Ricsi1231/BLDC-Motor-Driver/BLDC Motor Driver/Documentation/Schematic/Schematic.pdf

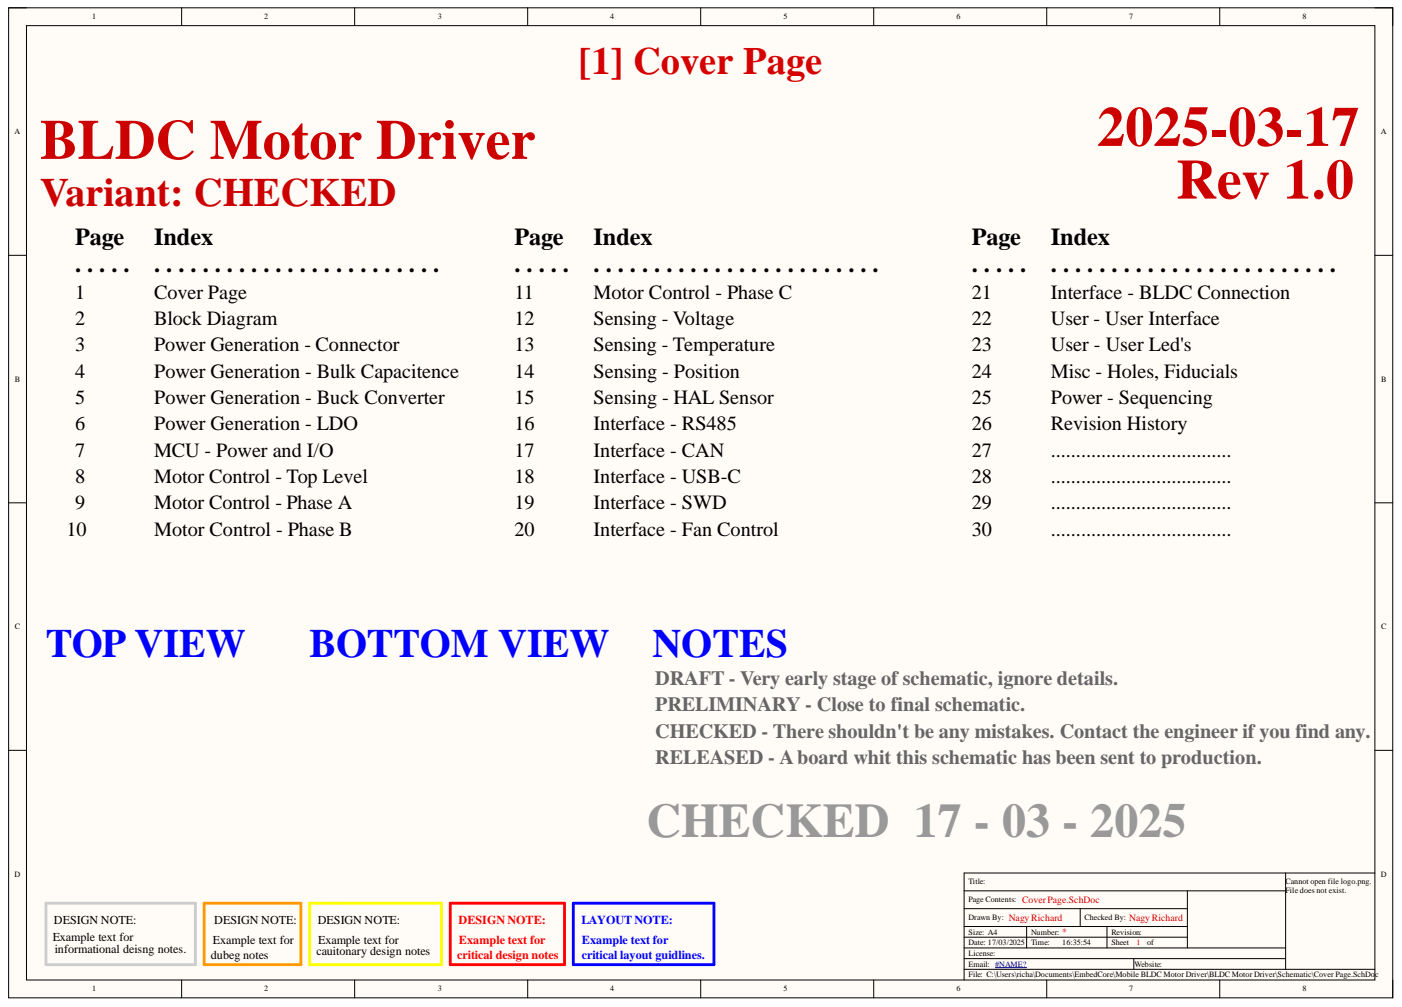
[picture p1: page 1]

Index
Cover Page
Block Diagram
Power Generation - Connector
Power Generation - Bulk Capacitence
Power Generation - Buck Converter
Power Generation - LDO
MCU - Power and I/O
Motor Control - Top Level
Motor Control - Phase A
Motor Control - Phase B

DRAFT - Very early stage of schematic, ignore details.
PRELIMINARY - Close to final schematic.
CHECKED - There shouldn't be any mistakes. Contact the engineer if you find any.
RELEASED - A board whit this schematic has been sent to production.
CHECKED 17 - 03 - 2025

Cannot open file logo.png.
File does not exist.

Page Contents: Cover Page.SchDoc

DESIGN NOTE:
Example text for cauitonary design notes

Drawn By: Nagy Richard | Checked By: Nagy Richard
Size: A4 | Number: * | Revision:
Date: 17/03/2025 | Time: 16:35:54 | Sheet of

License:
Email: #NAME?
C:\Users\richa\Documents\EmbedCore\Mobile BLDC Motor Driver\BLDC Motor Driver\Schematic\Cover Page.SchDoc

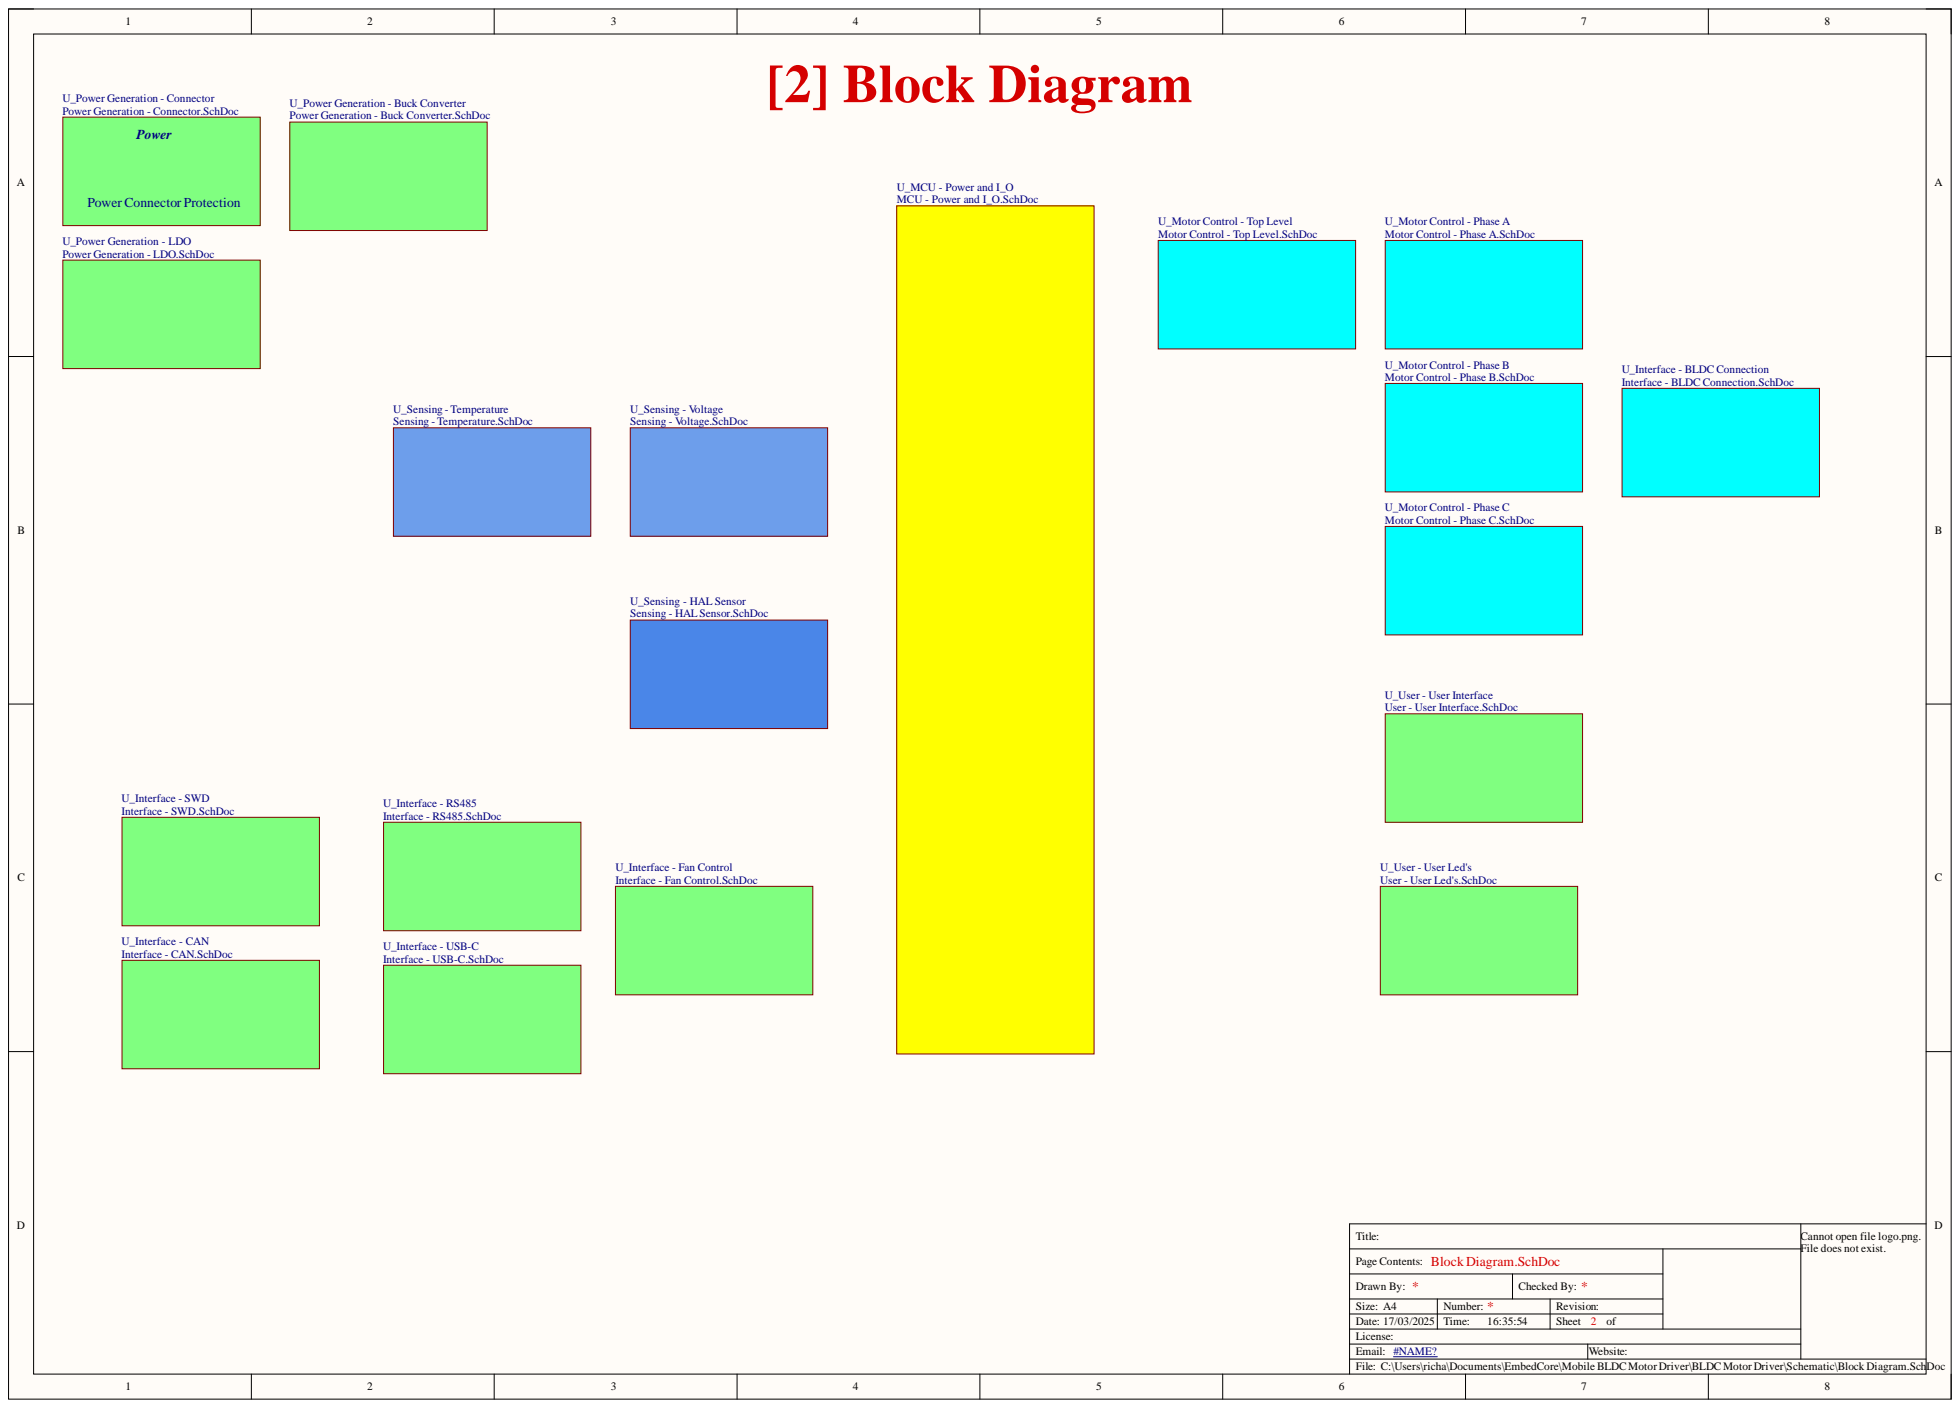
[picture p2: page 2]

U_MCU - Power and I_O
MCU - Power and I_O.SchDoc

U_Motor Control - Top Level
Motor Control - Top Level.SchDoc

U_Motor Control - Phase A
Motor Control - Phase A.SchDoc

U_Power Generation - LDO
Power Generation - LDO.SchDoc

U_Motor Control - Phase B
Motor Control - Phase B.SchDoc

U_Interface - BLDC Connection
Interface - BLDC Connection.SchDoc

U_Motor Control - Phase C
Motor Control - Phase C.SchDoc

U_User - User Interface
User - User Interface.SchDoc

U_Interface - Fan Control
Interface - Fan Control.SchDoc

U_User - User Led's
User - User Led's.SchDoc

Cannot open file logo.png.
File does not exist.

Page Contents: Block Diagram.SchDoc

Drawn By: * | Checked By: *
Size: A4 | Number: * | Revision:
Date: 17/03/2025 | Time: 16:35:54 | Sheet of

License:
Email: #NAME?
C:\Users\richa\Documents\EmbedCore\Mobile BLDCMotor Driver\BLDCMotor Driver\Schematic\Block Diagram.SchDoc

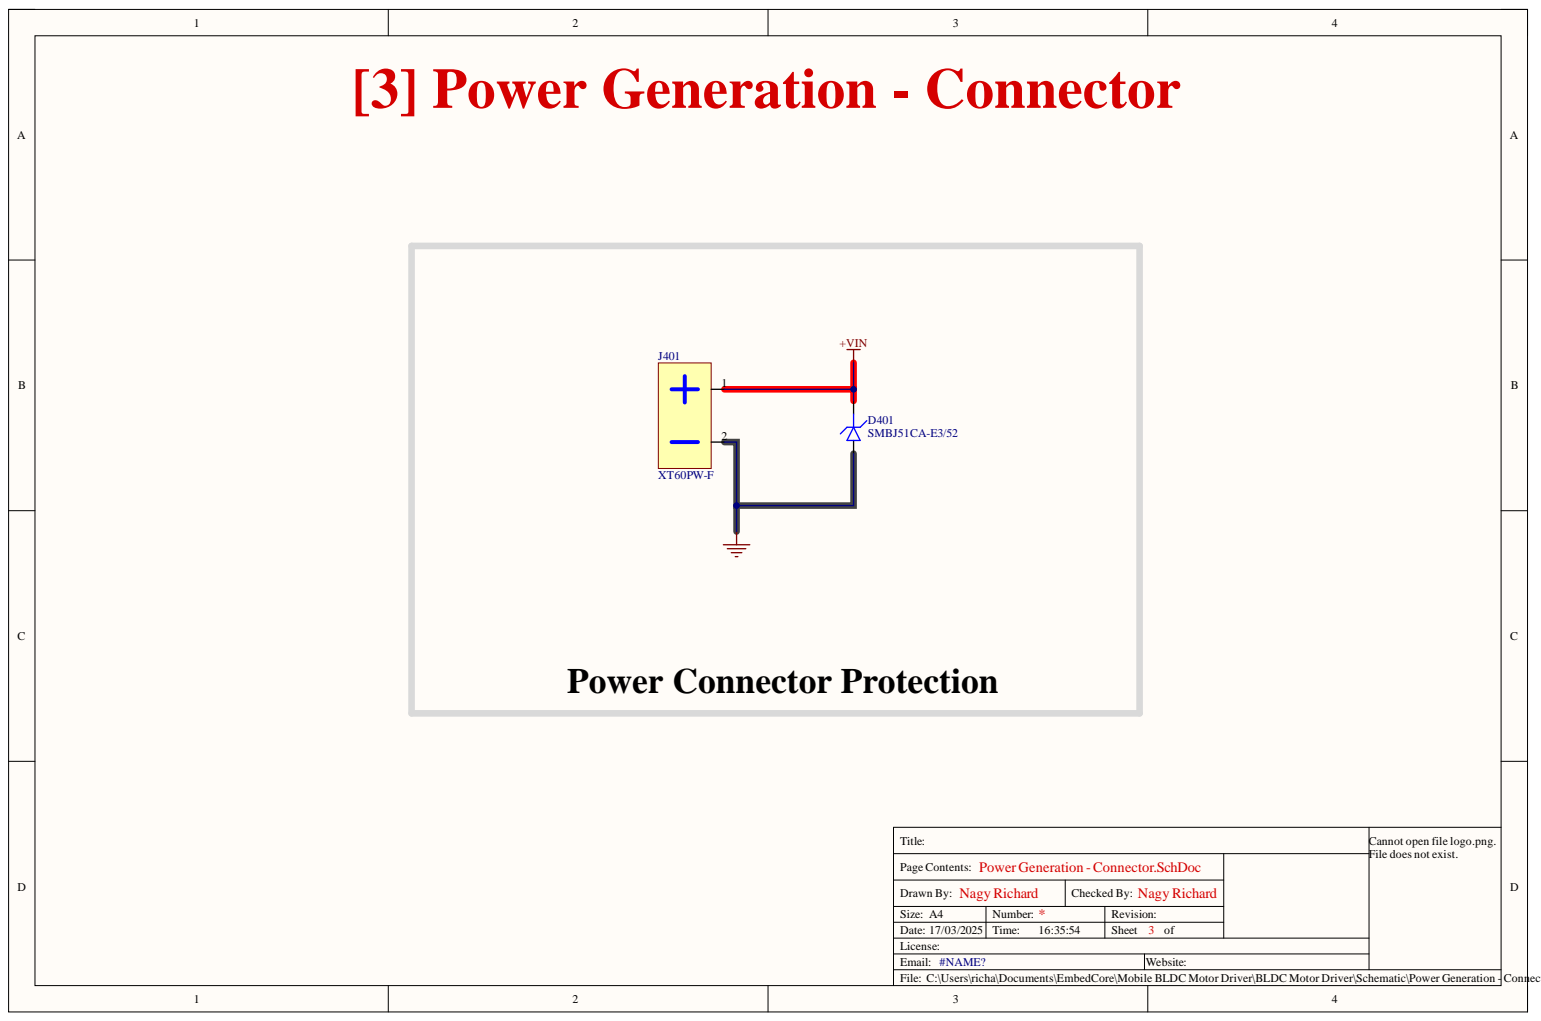
[picture p3: page 3]

Page Co n ten t s : P ower Ge n eratio n - Co n n e cto r.S c h D o c

Draw n By : Na g yRic h ard | Checked By : Na g yRic h ard
Size : A 4 | * N umb er : | Rev i s i o n :
Dat e : 1 7 / 0 3 / 2 0 2 5 | T ime : 1 6 : 3 5 : 5 4 | Shee t 3 o f

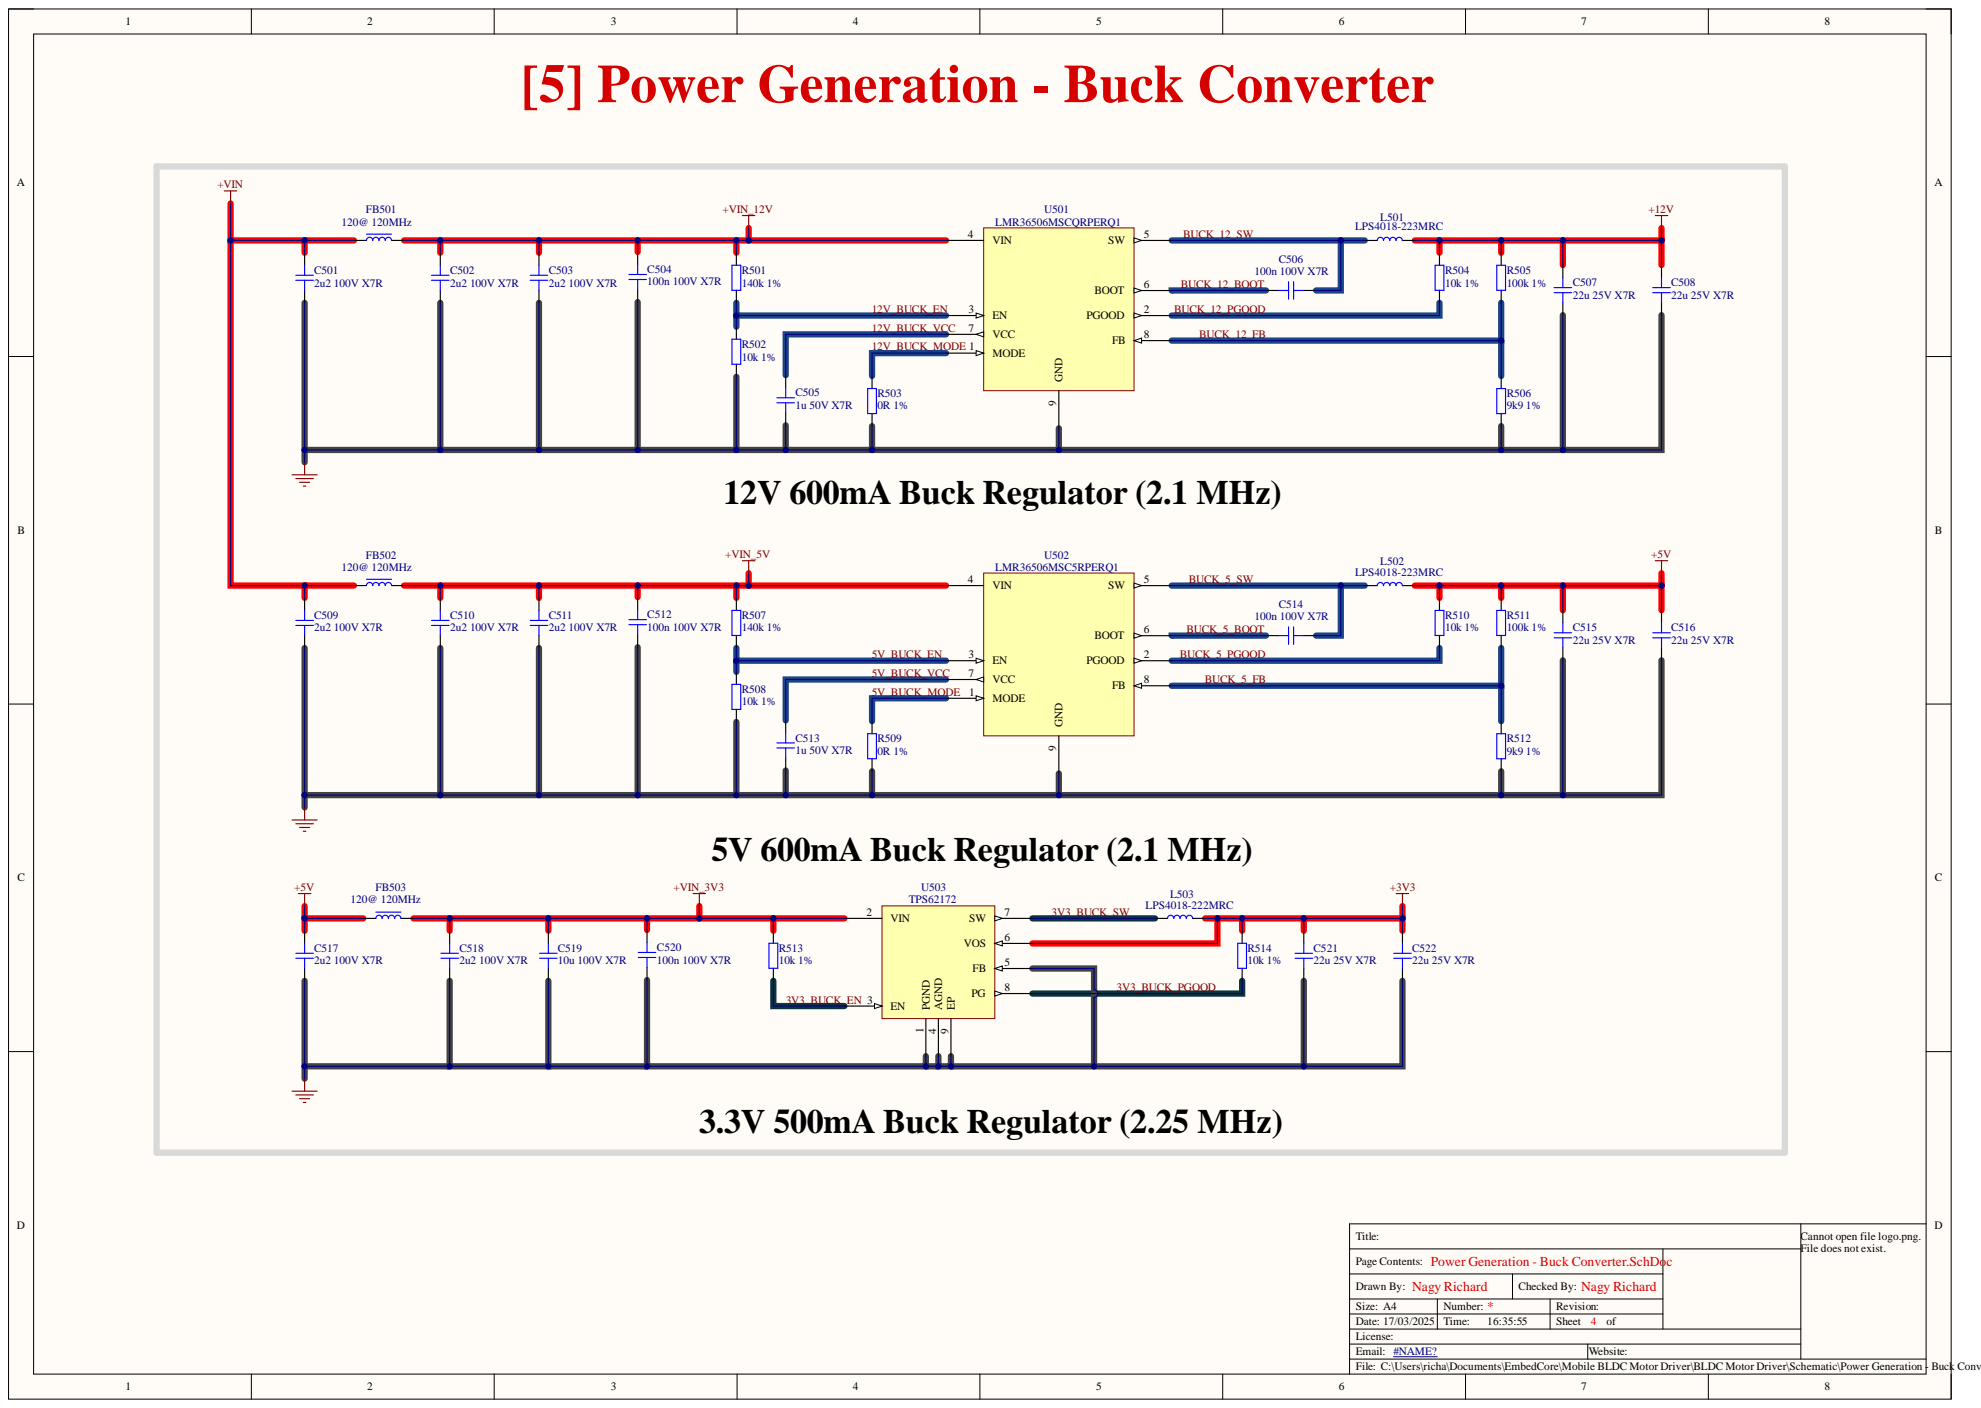
[picture p4: page 4]

[5] Power Generation - Buck Converter

12V_BUCK_VCC | VCC 7 | BUCK_12_FB
12V_BUCK_MODE

5V_BUCK_VCC | VCC 7 | BUCK_5_FB
5V_BUCK_MODE

Cannot open file logo.png.
File does not exist.

Page Contents: Power Generation - Buck Converter.SchDoc

Drawn By: Nagy Richard | Checked By: Nagy Richard
Size: A4 | Number: * | Revision:
Date: 17/03/2025 | Time: 16:35:55 | Sheet of

License:
Email: #NAME?
C:\Users\richa\Documents\EmbedCore\Mobile BLDC Motor Driver\BLDC Motor Driver\Schematic\Power Generation - Buck Converter.SchDoc

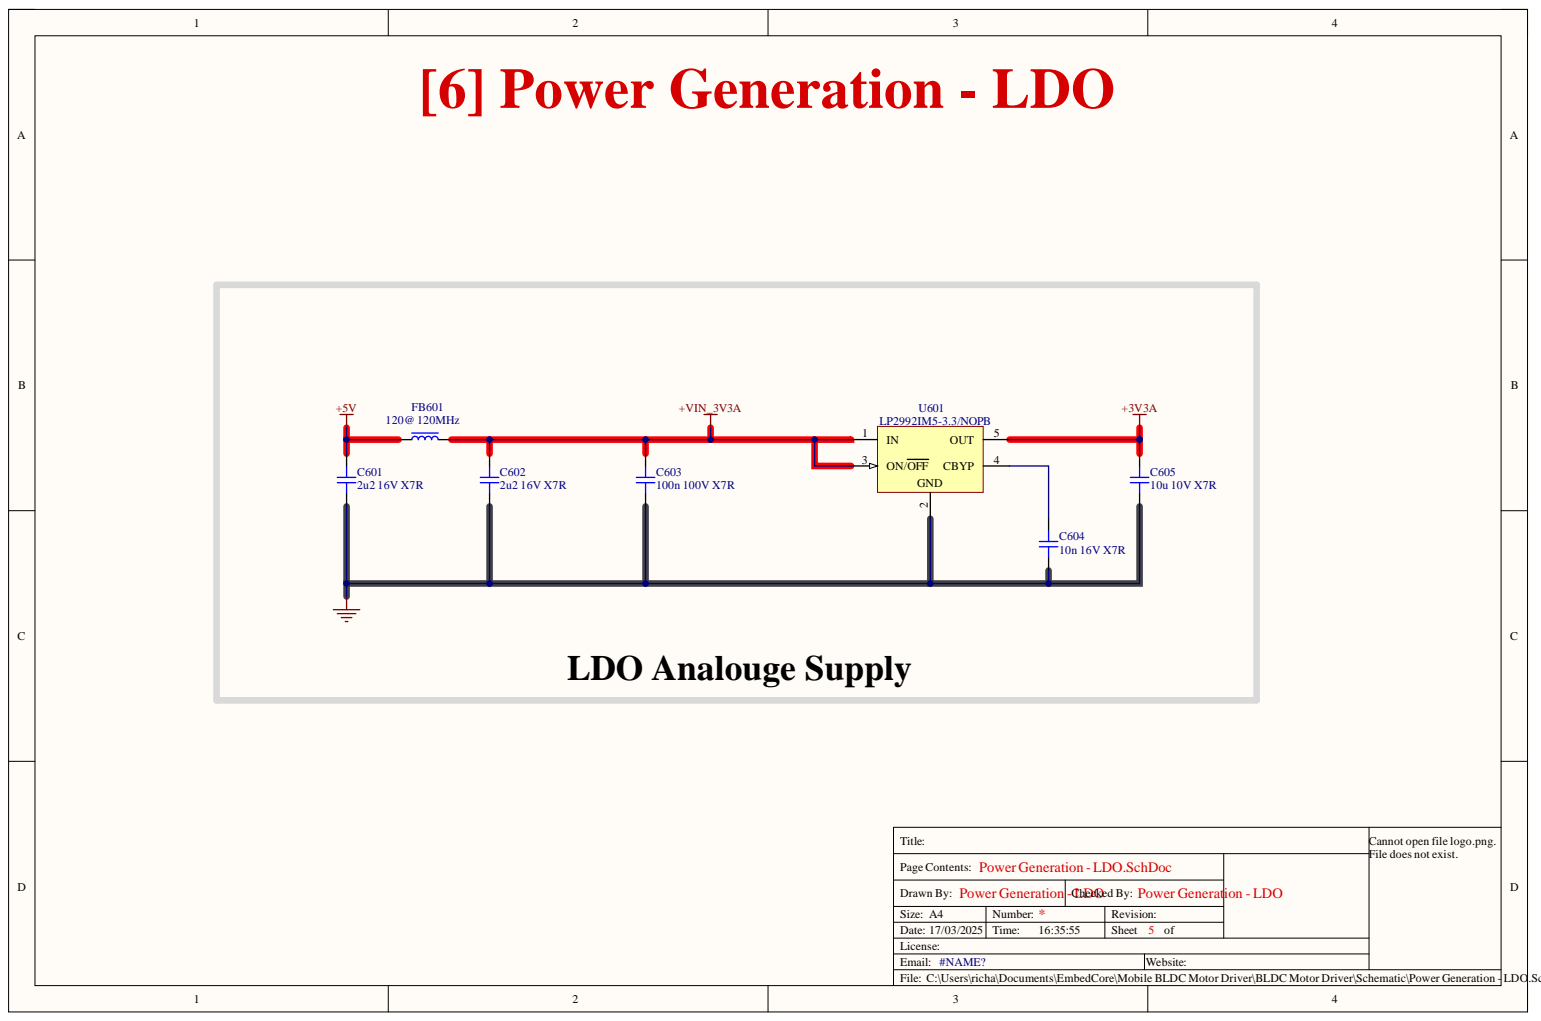
[picture p5: page 5]

Page Co n ten t s : P ower Ge n eratio n - LDO.S c h D o c | n - LDO

Draw n By : P ower Ge n eratio n - ChLDOecked By | : P ower Ge n eratio
Size : A 4 | * N umb er : | Rev i s i o n :
Dat e : 1 7 / 0 3 / 2 0 2 5 | T ime : 1 6 : 3 5 : 5 5 | Shee t 5 o f

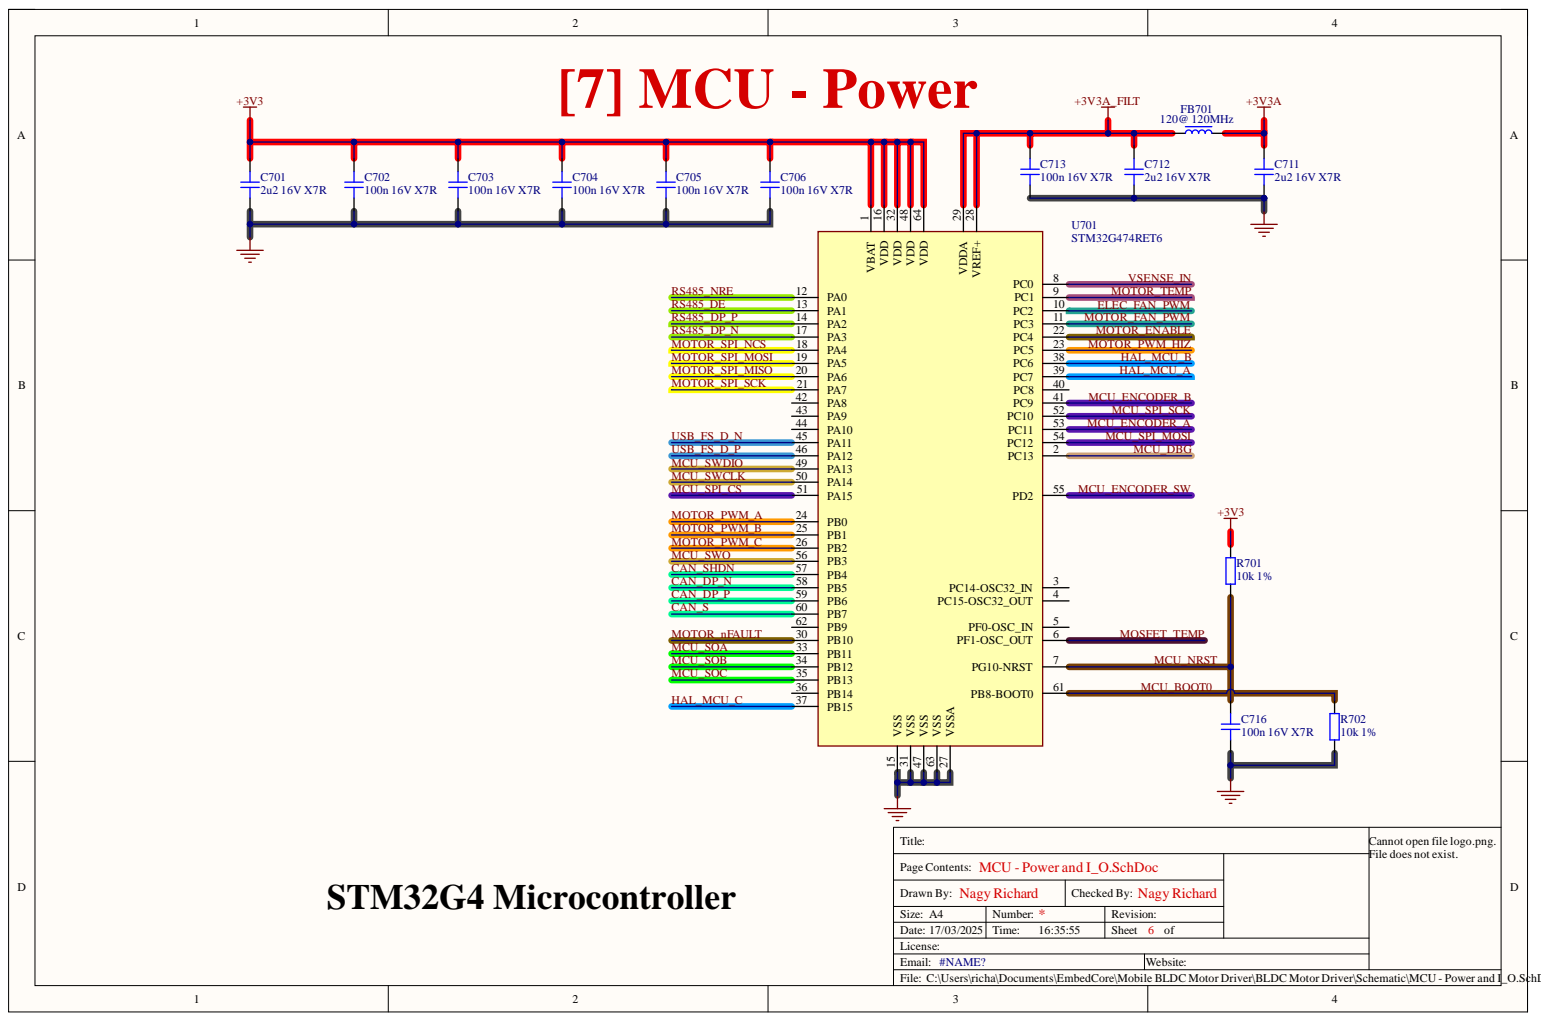
[picture p6: page 6]

Page Co n ten t s : MCU -P ower a n d I_O.S c hDo

Draw n By : Na g yRic h ard | Checked By : Na g yRic h ard
Size : A 4 | * N umb er : | Rev i s i o n :
Dat e : 1 7 / 0 3 / 2 0 2 5 | T ime : 1 6 : 3 5 : 5 5 | Shee t 6 o f

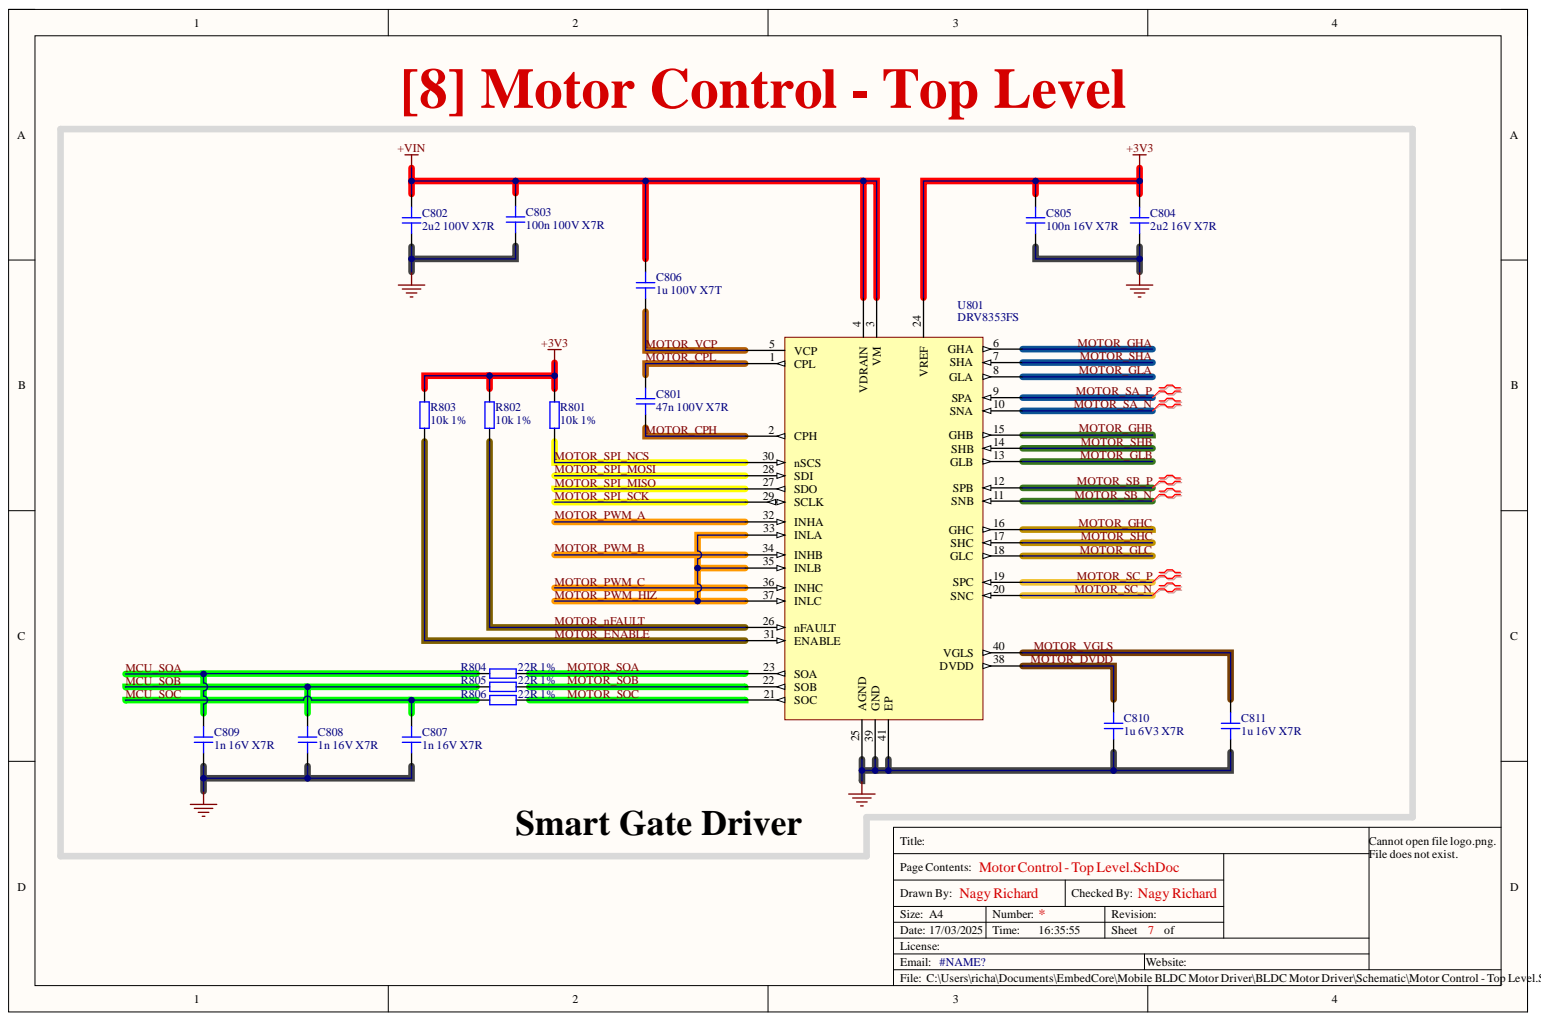
[picture p7: page 7]

[8] Motor Control - Top Level

Page Co n ten t s : M otor Co ntrol -To p Le v el.S c hDo c

Draw n By : Na g yRic h ard | Checked By : Na g yRic h ard
Size : A 4 | * N umb er : | Rev i s i o n :
Dat e : 1 7 / 0 3 / 2 0 2 5 | T ime : 1 6 : 3 5 : 5 5 | Shee t 7 o f

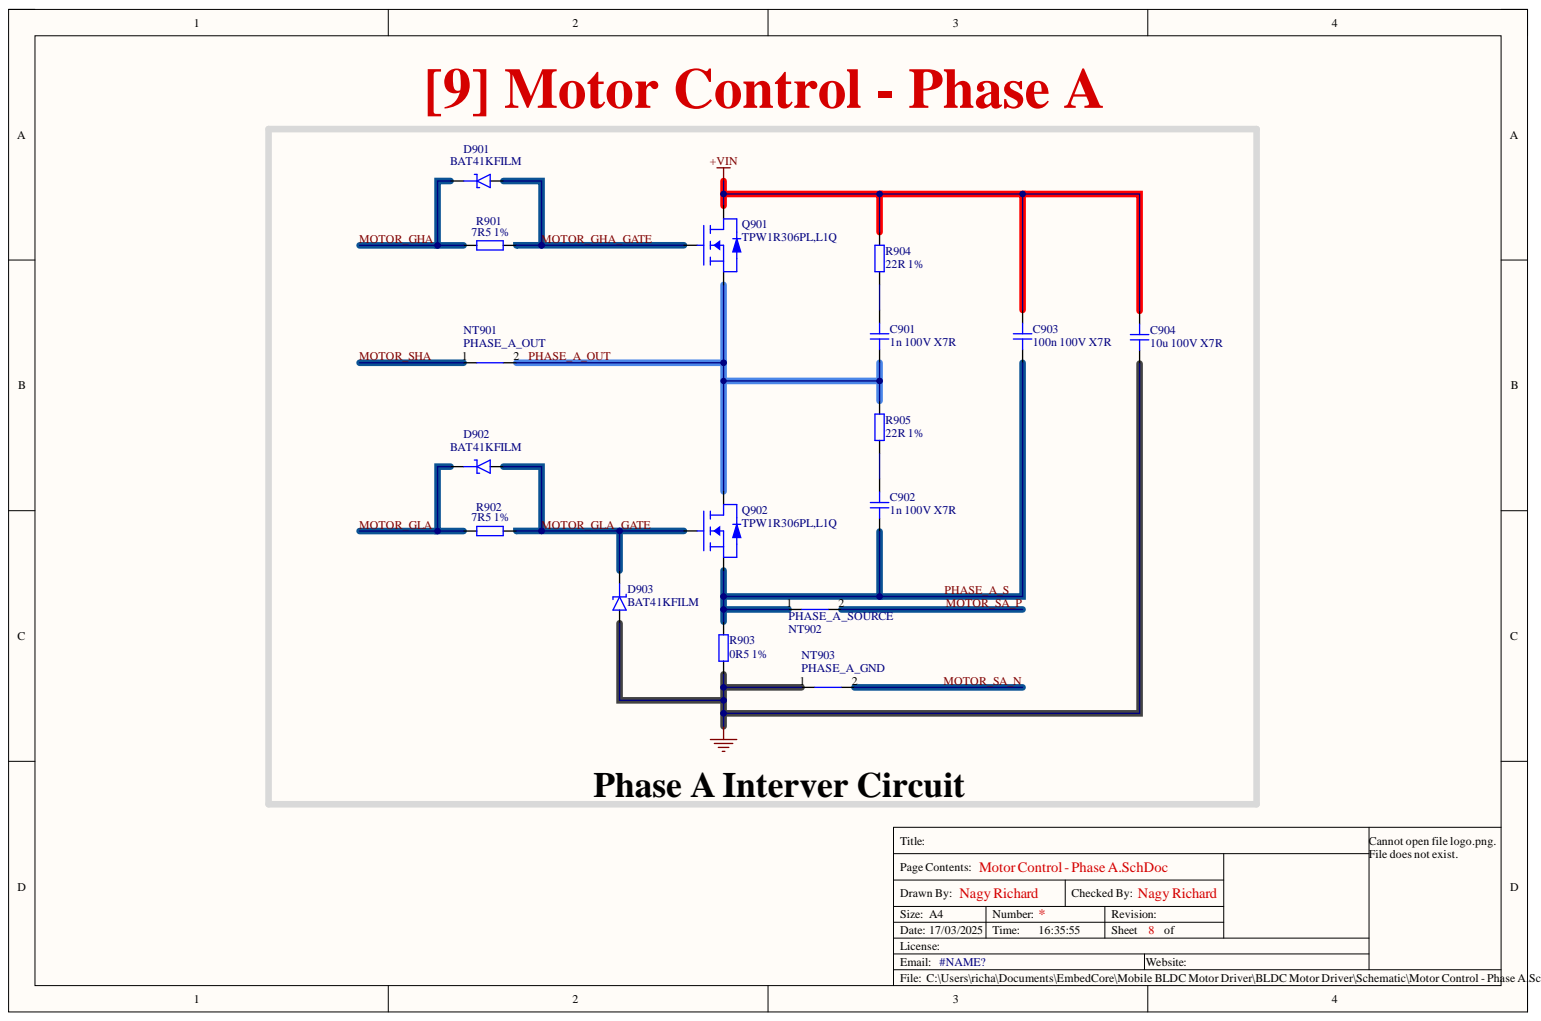
[picture p8: page 8]

Cannot open file logo.png.
File does not exist.

Page Contents: Motor Control - Phase A.SchDoc

Drawn By: NagyRichard | Checked By: NagyRichard
Size: A4 | * Number: | Revision:
Date: 17/03/2025 | Time: 16:35:55 | Sheet 8 of

License:
Email: #NAME?
C:\Users\richa\Documents\EmbedCore\Mobile BLDC Motor Driver\BLDC Motor Driver\Schematic\Motor Control - Phase A.SchDoc

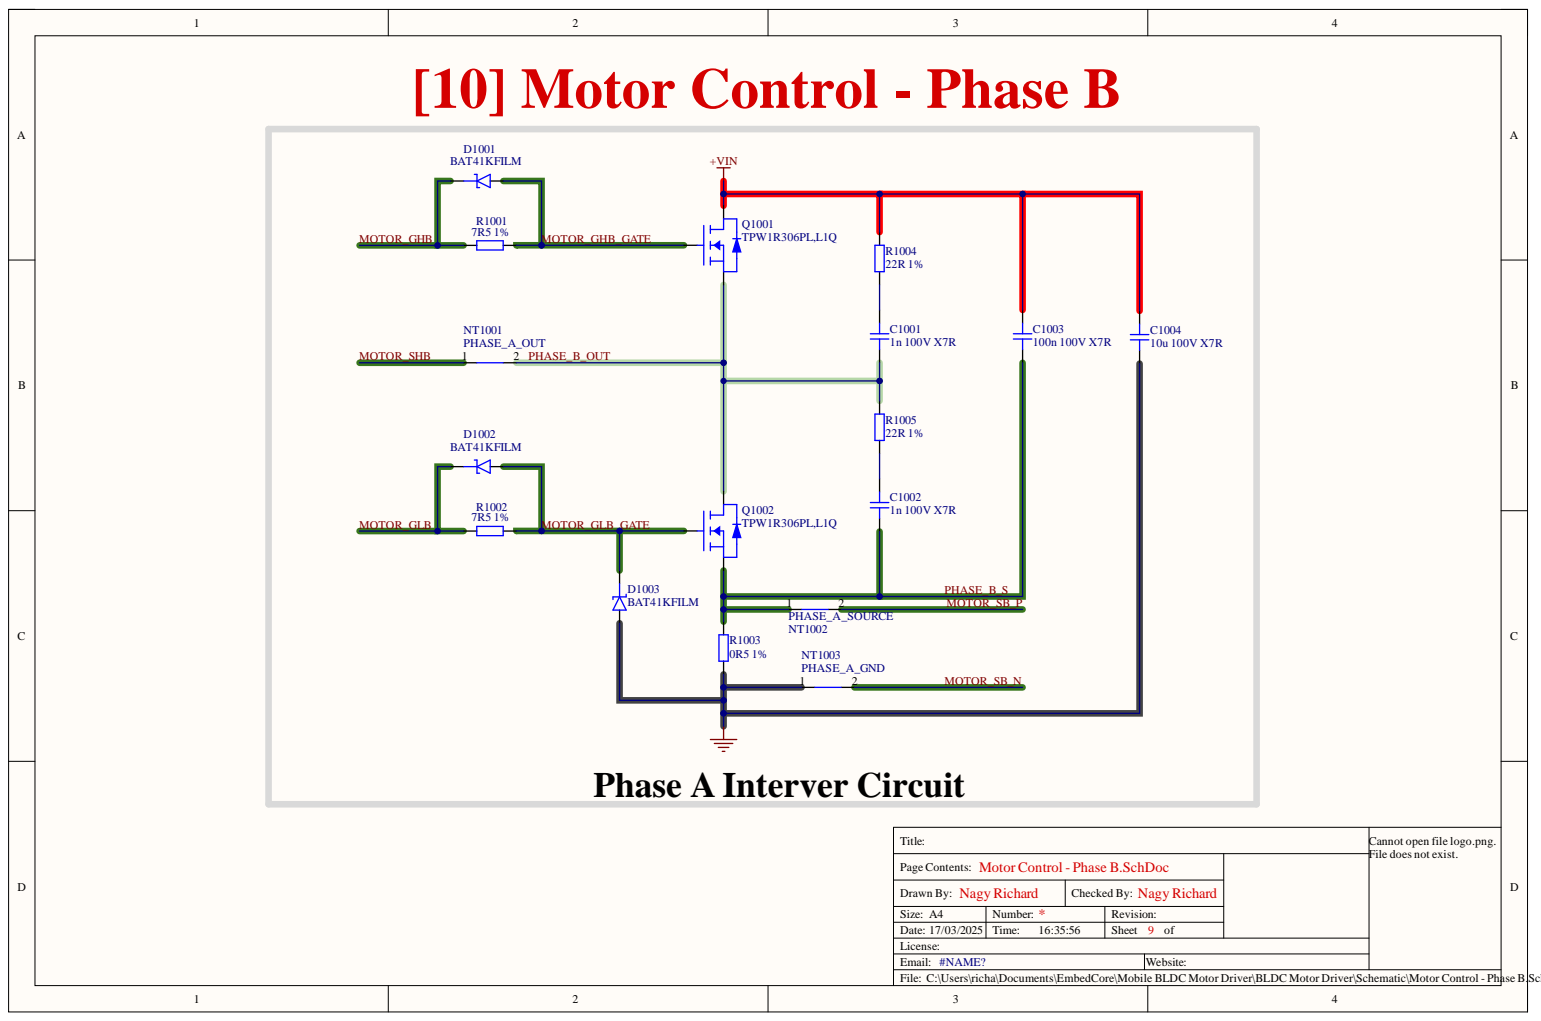
[picture p9: page 9]

Cannot open file logo.png.
File does not exist.

Page Contents: Motor Control - Phase B.SchDoc

Drawn By: NagyRichard | Checked By: NagyRichard
Size: A4 | * Number: | Revision:
Date: 17/03/2025 | Time: 16:35:56 | Sheet 9 of

License:
Email: #NAME?
C:\Users\richa\Documents\EmbedCore\Mobile BLDC Motor Driver\BLDC Motor Driver\Schematic\Motor Control - Phase B.SchDoc

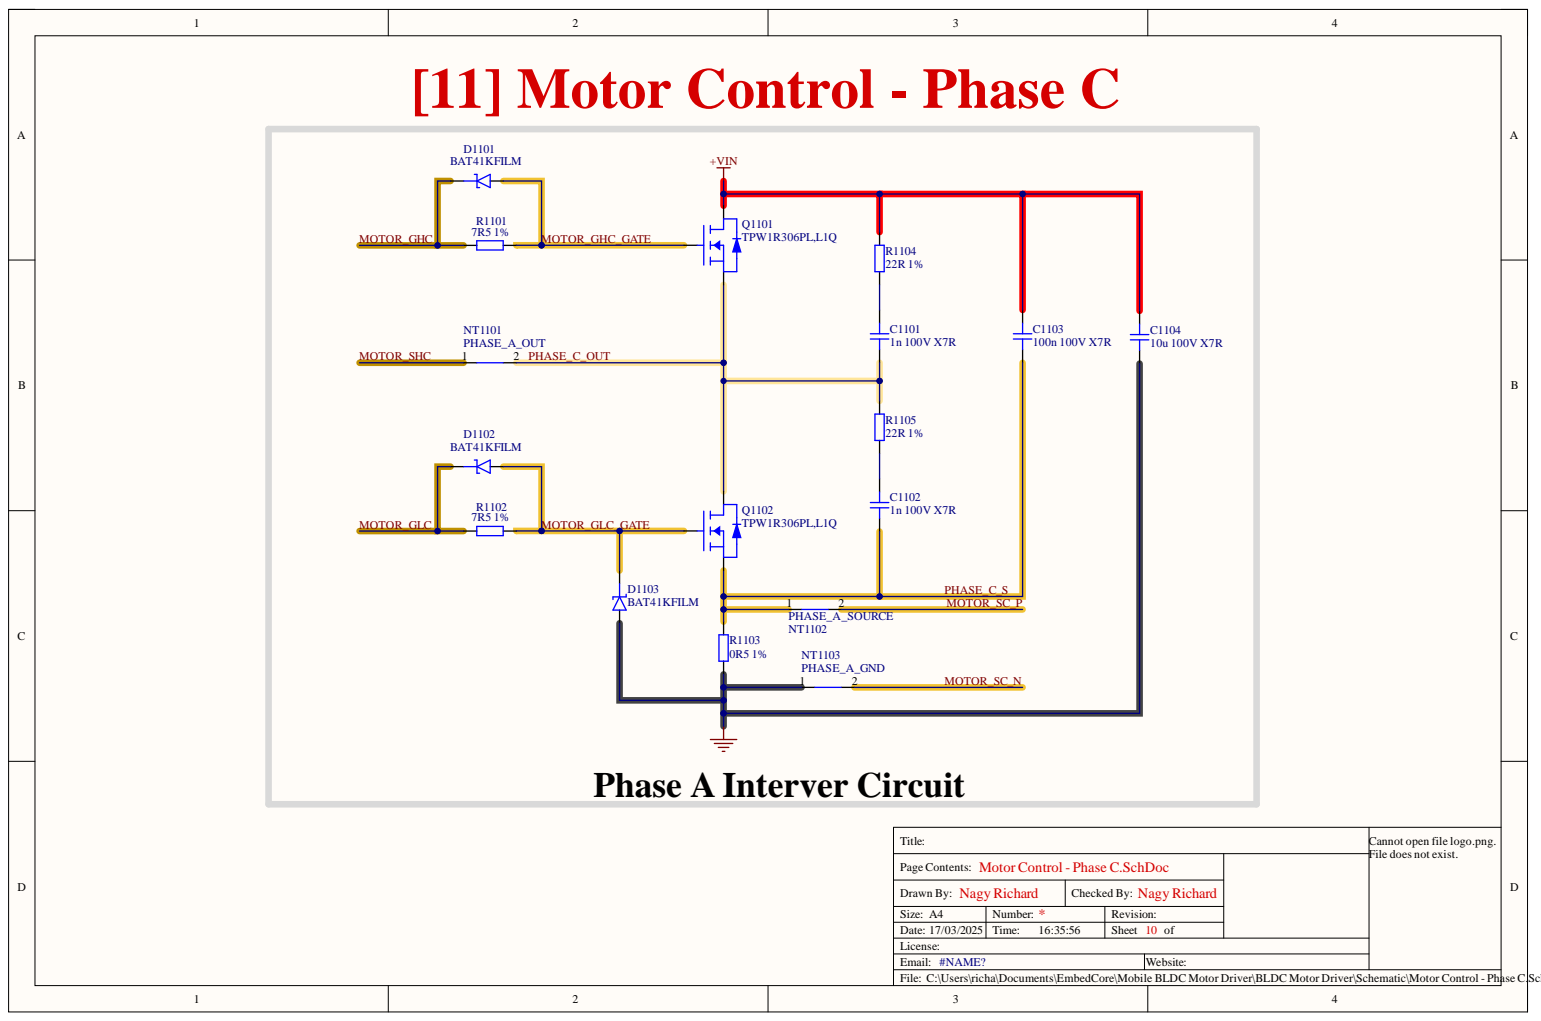
[picture p10: page 10]

Cannot open file logo.png.
File does not exist.

Page Contents: Motor Control - Phase C.SchDoc

Drawn By: NagyRichard | Checked By: NagyRichard
Size: A4 | * Number: | Revision:
Date: 17/03/2025 | Time: 16:35:56 | Sheet 10 of

License:
Email: #NAME?
C:\Users\richa\Documents\EmbedCore\Mobile BLDC Motor Driver\BLDC Motor Driver\Schematic\Motor Control - Phase C.SchDoc

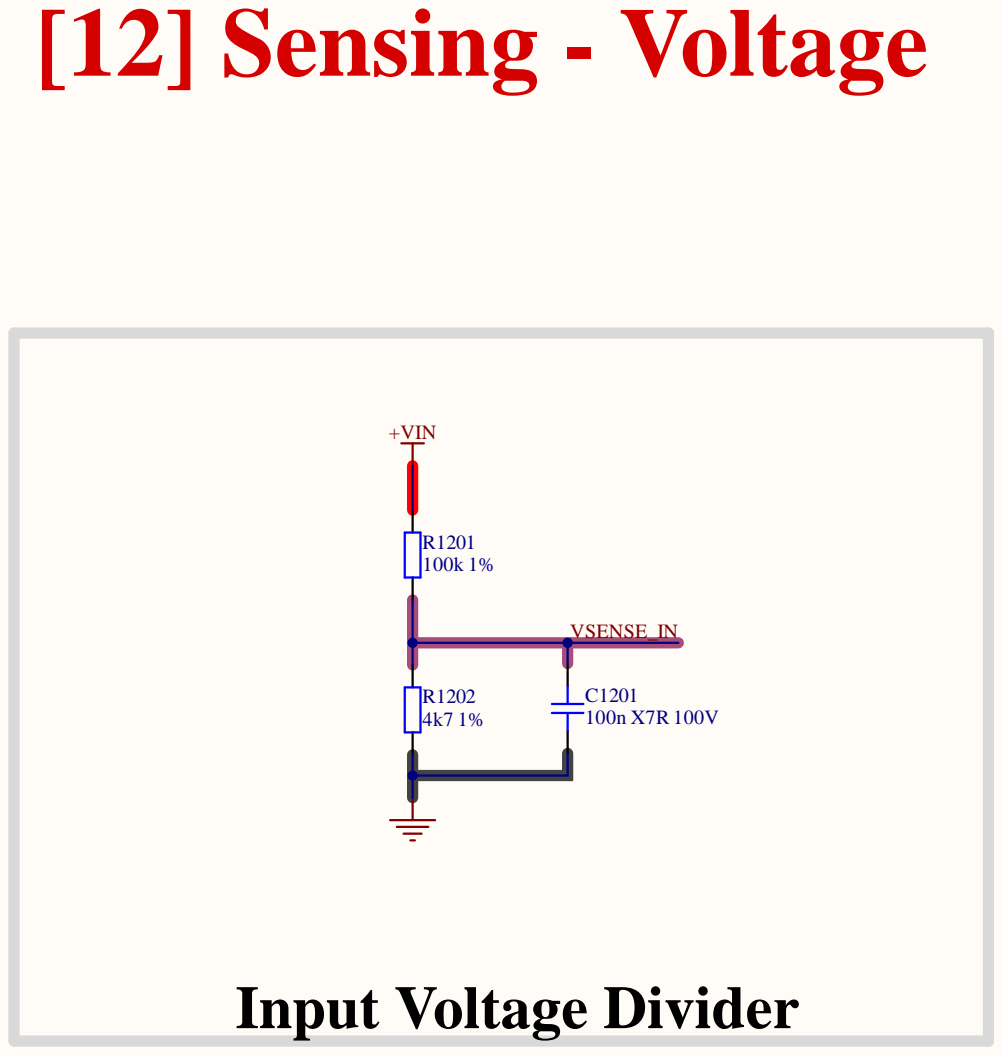
[picture p11: page 11]

Cannot open file logo.png.
File does not exist.

Page Contents: Sensing - Voltage.SchDoc

Drawn By: NagyRichard | Checked By: NagyRichard
Size: A4 | 10 Number: | Revision:
Date: 17/03/2025 | Time: 16:35:56 | Sheet 11 of

License:
Email: #NAME?
C:\Users\richa\Documents\EmbedCore\Mobile BLDC Motor Driver\BLDC Motor Driver\Schematic\Sensing - Voltage.SchDoc

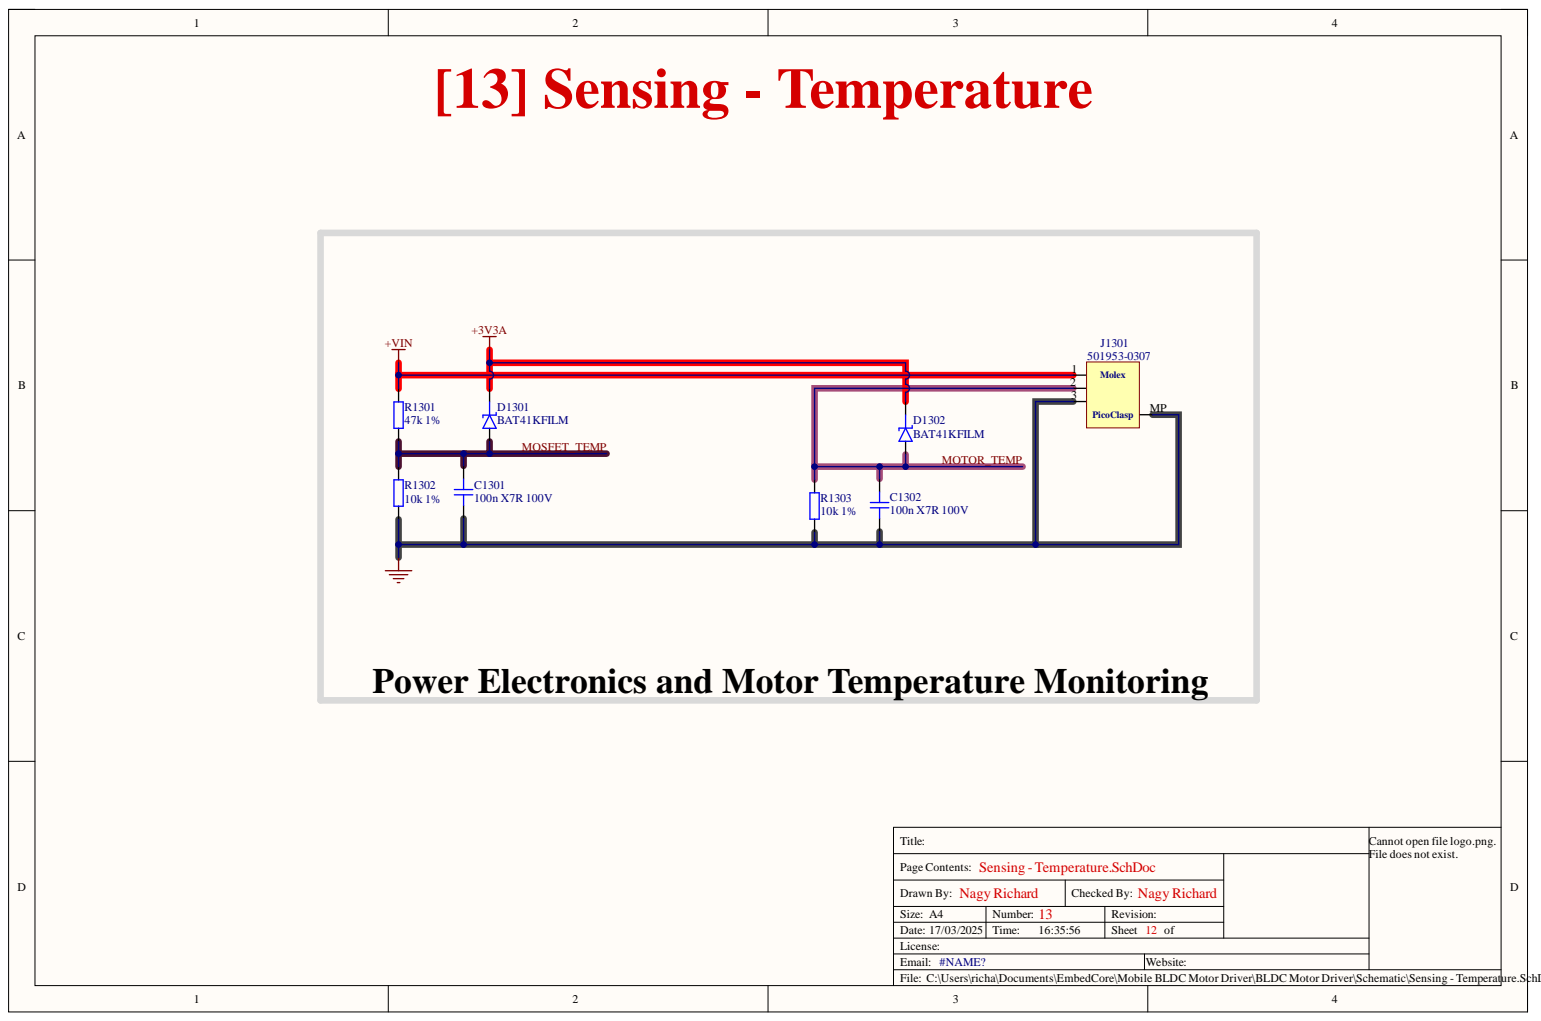
[picture p12: page 12]

Power Electronics and Motor

Page Co n ten t s : S e nsin g -Temp erature . S c h D o

Draw n By : Na g yRic h ard | Checked By : Na g yRic h ard
Size : A 4 | 1 3 N umb er : | Rev i s i o n :
Dat e : 1 7 / 0 3 / 2 0 2 5 | T ime : 1 6 : 3 5 : 5 6 | Shee t 1 2 o f

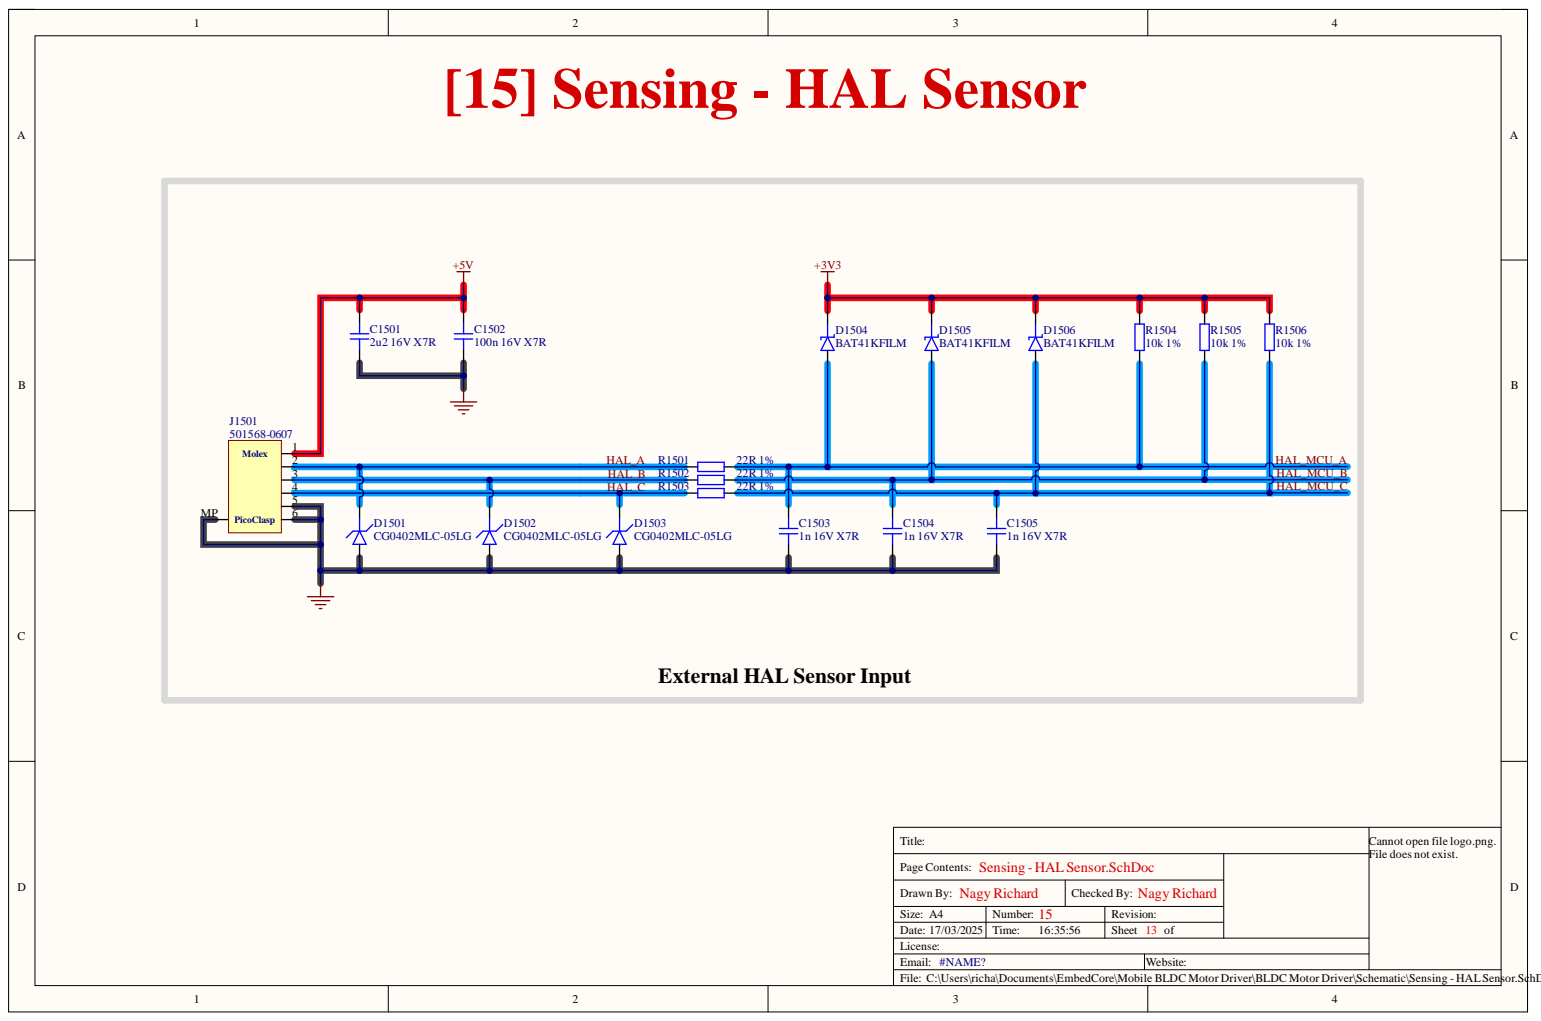
[picture p13: page 13]

External HAL Sensor Input

Cannot open file logo.png.
File does not exist.

Page Contents: Sensing - HALSensor.SchDoc

Drawn By: NagyRichard | Checked By: NagyRichard
Size: A4 | 15 Number: | Revision:
Date: 17/03/2025 | Time: 16:35:56 | Sheet 13 of

License:
Email: #NAME?
C:\Users\richa\Documents\EmbedCore\Mobile BLDC Motor Driver\BLDC Motor Driver\Schematic\Sensing - HALSensor.SchDoc

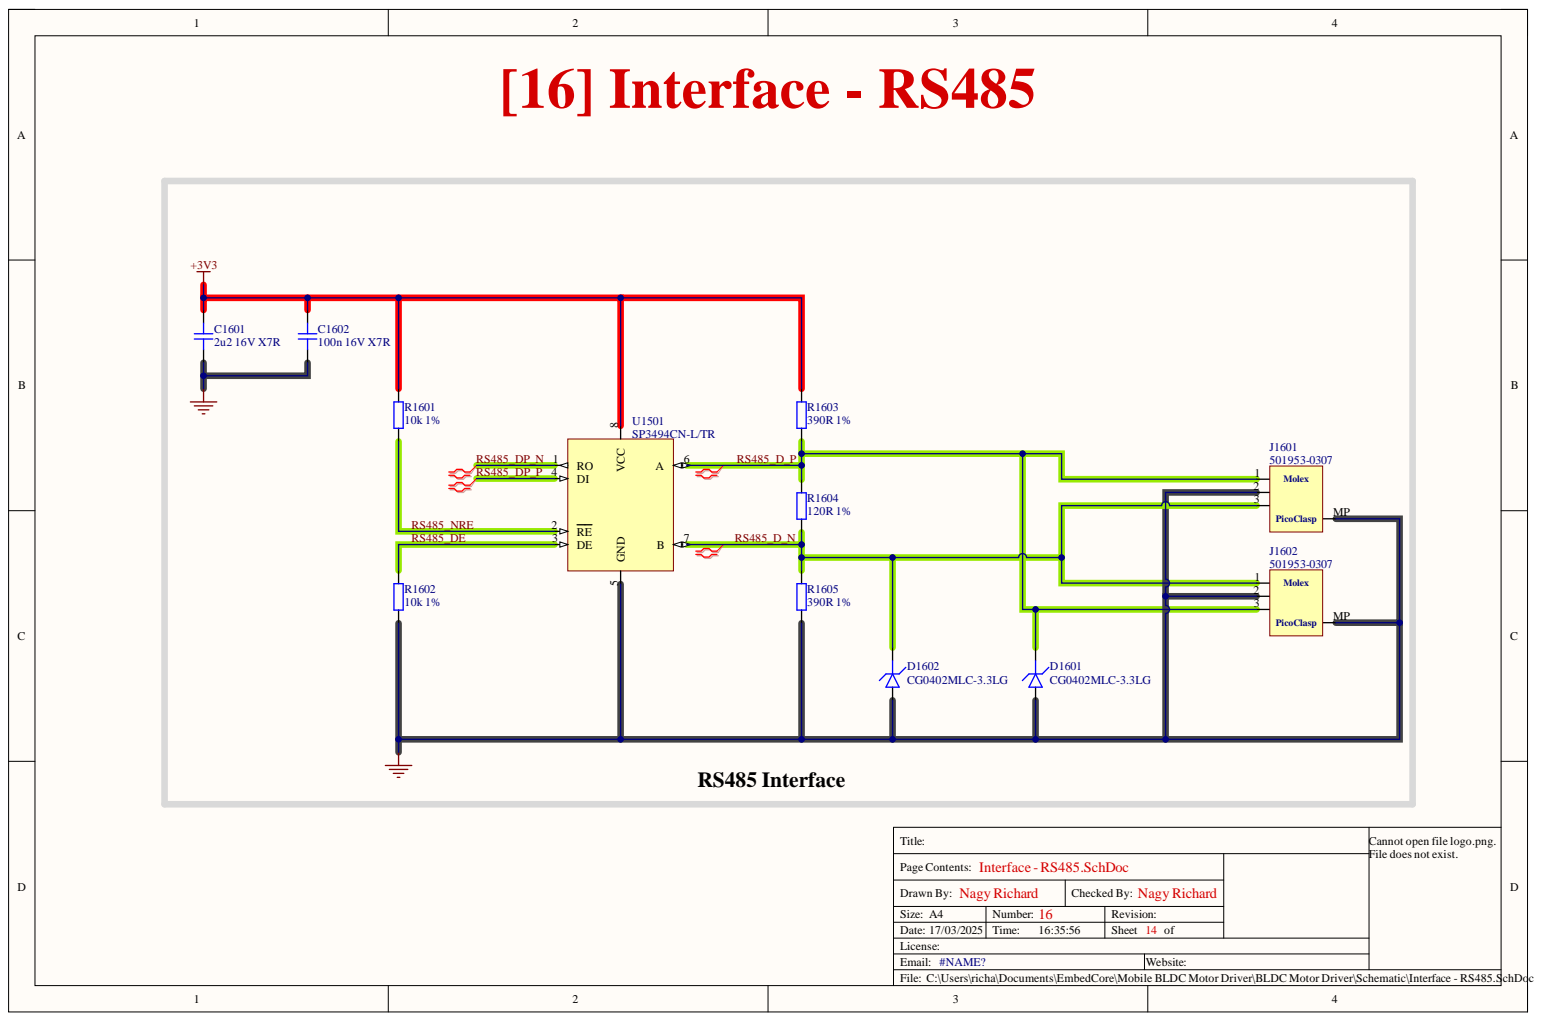
[picture p14: page 14]

Page Co n ten t s : Interfa c e - RS 4 8 5.S c h D o c

Draw n By : Na g yRic h ard | Checked By : Na g yRic h ard
Size : A 4 | 1 6 N umb er : | Rev i s i o n :
Dat e : 1 7 / 0 3 / 2 0 2 5 | T ime : 1 6 : 3 5 : 5 6 | Shee t 1 4 o f

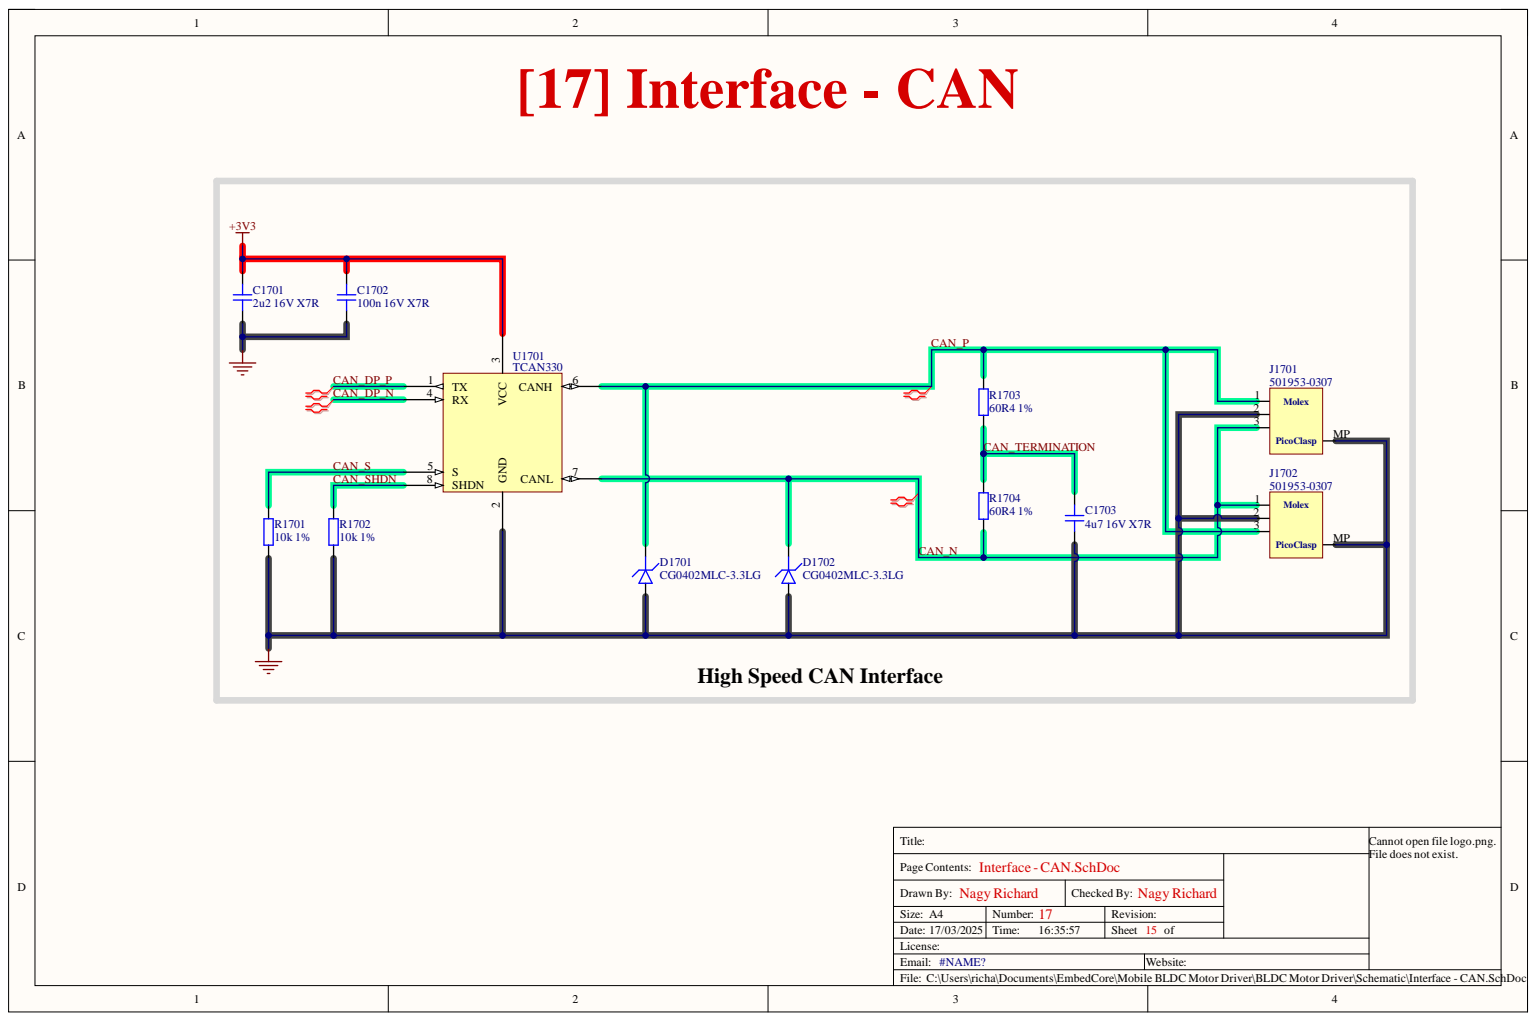
[picture p15: page 15]

High Speed CAN Interface

Page Co n ten t s : Interfa c e - CAN.S c h D o c

Draw n By : Na g yRic h ard | Checked By : Na g yRic h ard
Size : A 4 | 1 7 N umb er : | Rev i s i o n :
Dat e : 1 7 / 0 3 / 2 0 2 5 | T ime : 1 6 : 3 5 : 5 7 | Shee t 1 5 o f

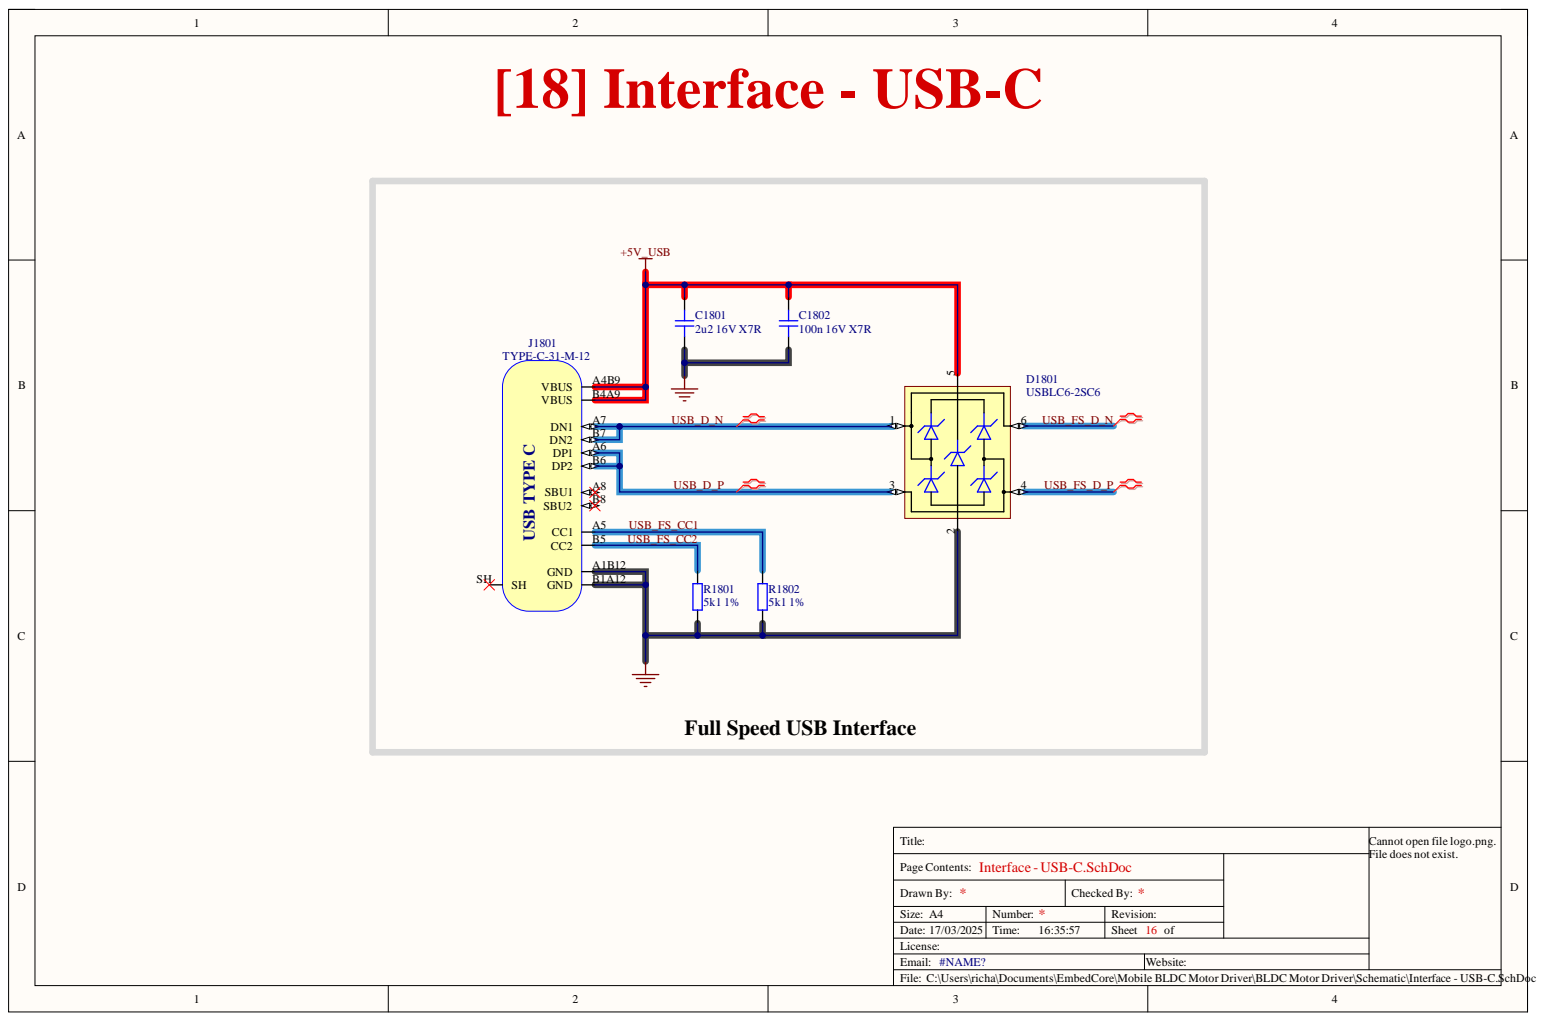
[picture p16: page 16]

Full Speed USB Interface

Cannot open file logo.png.
File does not exist.

Page Contents: Interface - USB-C.SchDoc

Drawn By: * | Checked By: *
Size: A4 | * Number: | Revision:
Date: 17/03/2025 | Time: 16:35:57 | Sheet 16 of

License:
Email: #NAME?
C:\Users\richa\Documents\EmbedCore\Mobile BLDC Motor Driver\BLDC Motor Driver\Schematic\Interface - USB-C.SchDoc

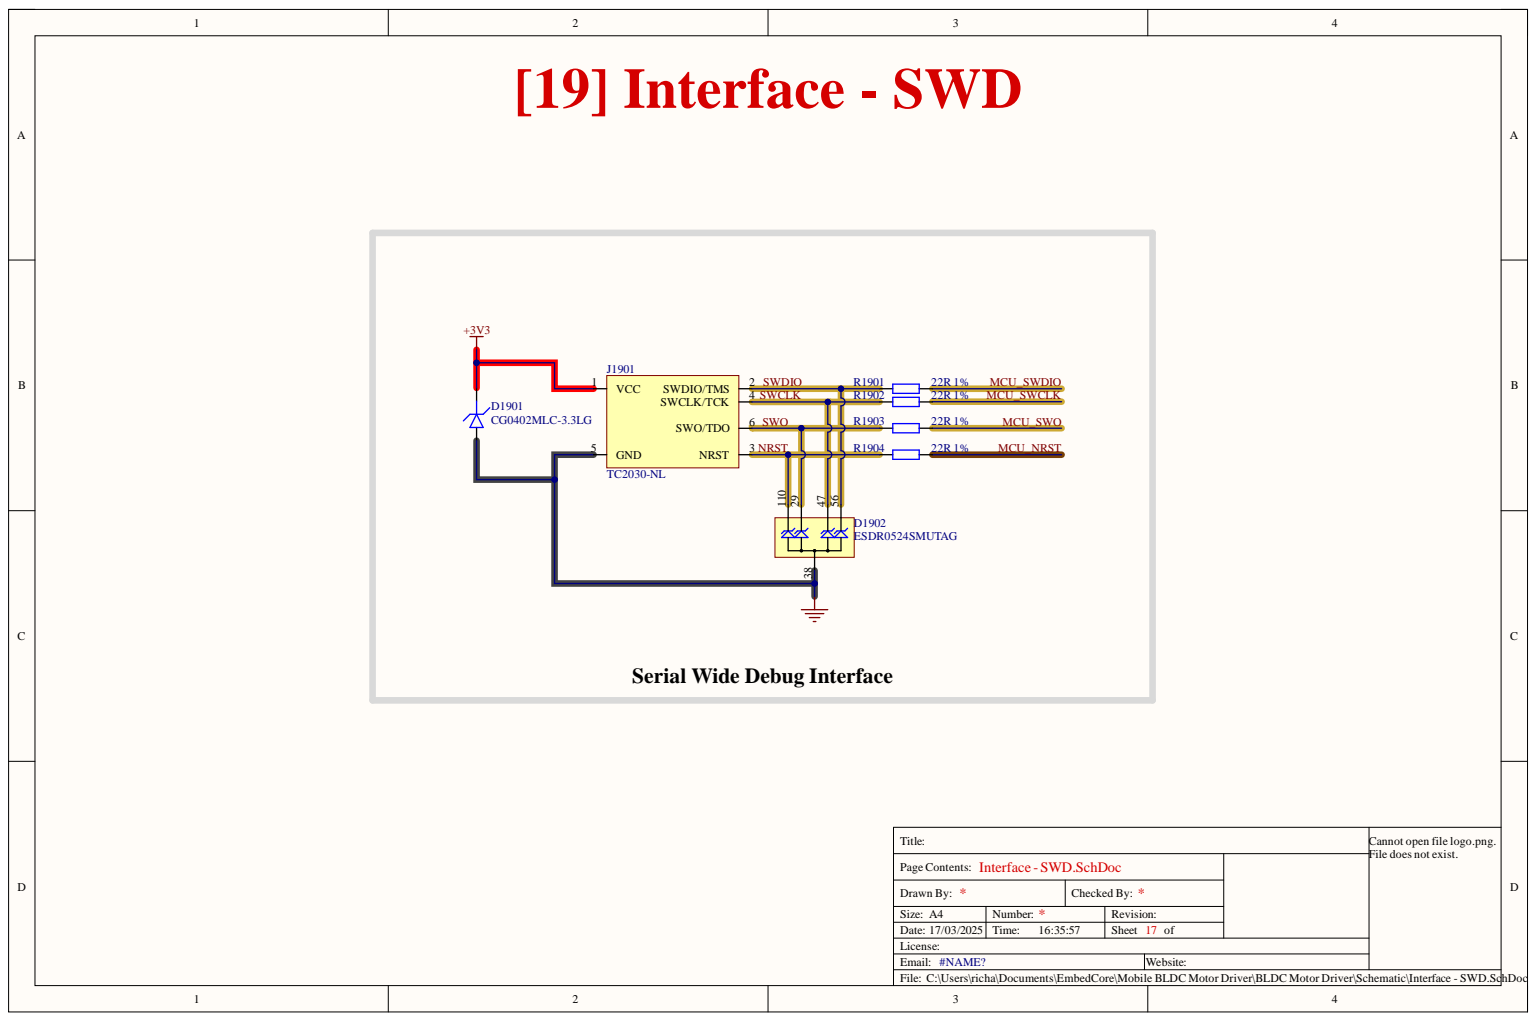
[picture p17: page 17]

CG 0 4 0 2MLC-3.3 L G | | 4 SWCL K | R1 9 0

3 NRS T | | | R1 9 0

Page Co n ten t s : Interfa c e -SWD.S c h D o c

Draw n By : * | Checked By : *
Size : A 4 | * N umb er : | Rev i s i o n :
Dat e : 1 7 / 0 3 / 2 0 2 5 | T ime : 1 6 : 3 5 : 5 7 | Shee t 1 7 o f

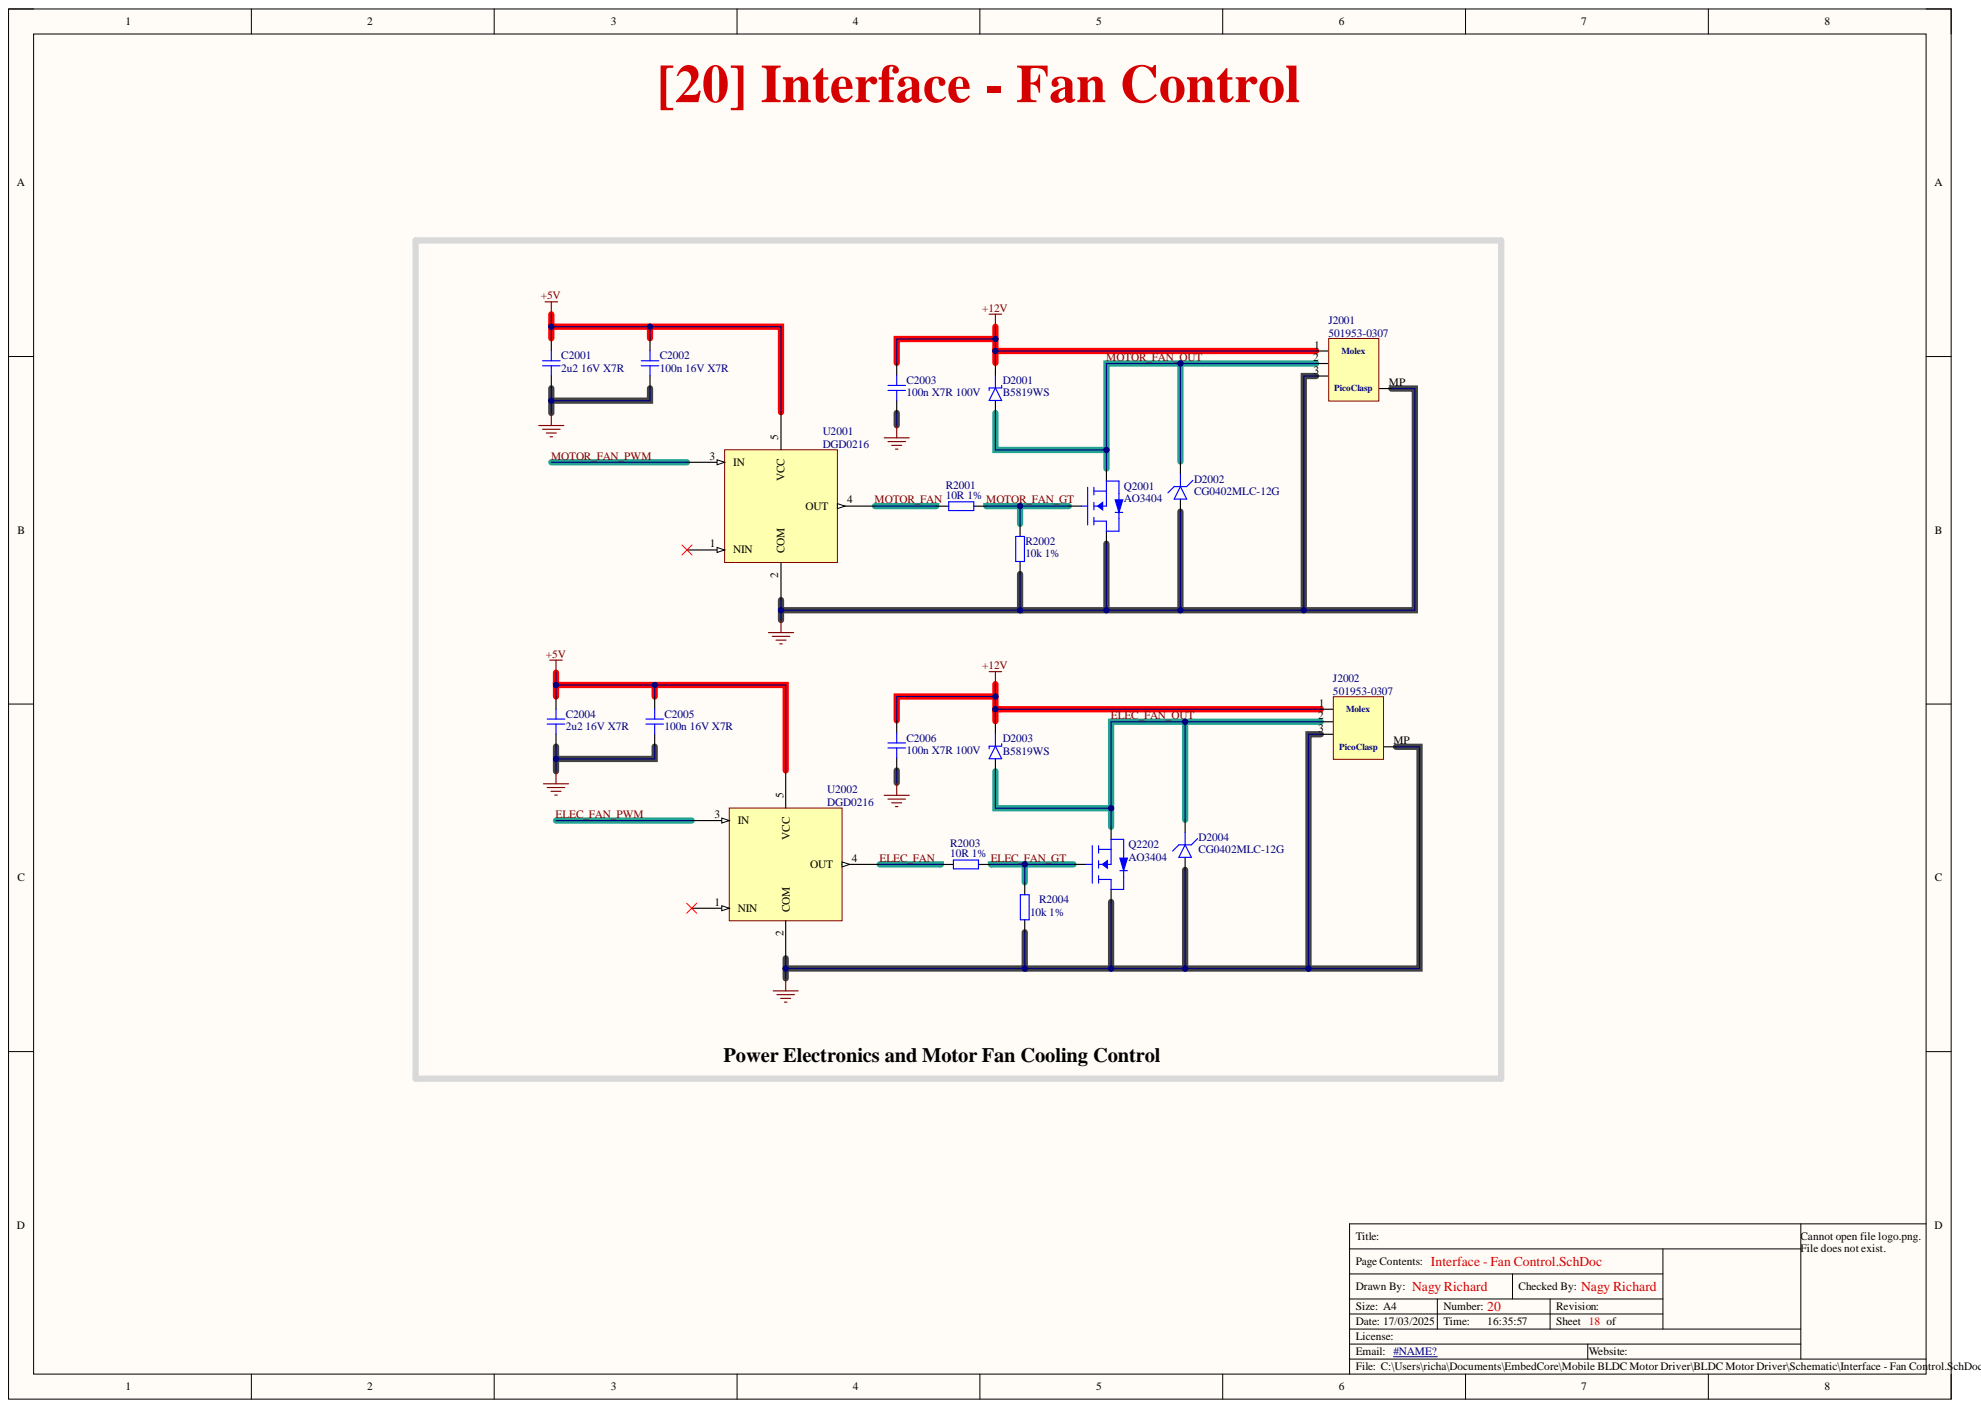
[picture p18: page 18]

MOTOR_FAN_OUT | 2

Power Electronics and Motor Fan Cooling Control

Cannot open file logo.png.
File does not exist.

Page Contents: Interface - Fan Control.SchDoc

Drawn By: Nagy Richard | Checked By: Nagy Richard

Size: A4 | Number: | Revision:
Date: 17/03/2025 | Time: 16:35:57 | Sheet of

License:
Email: #NAME?
C:\Users\richa\Documents\EmbedCore\Mobile BLDC Motor Driver\BLDC Motor Driver\Schematic\Interface - Fan Control.SchDoc

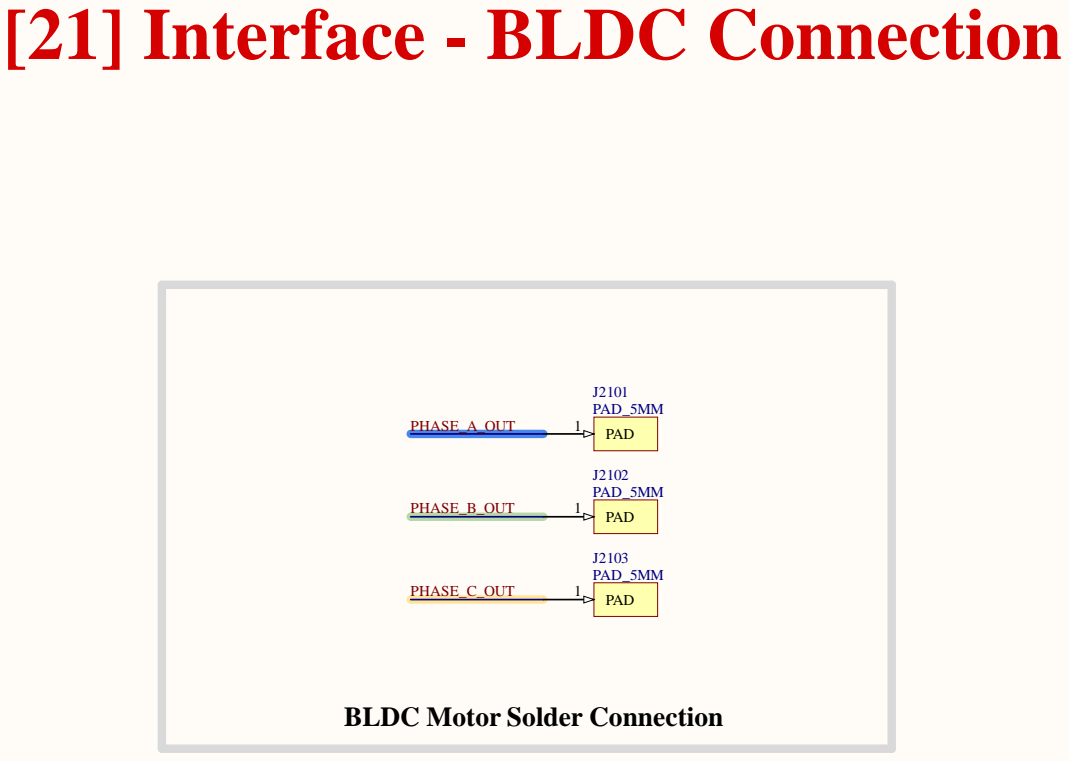
[picture p19: page 19]

BLDC Motor Solder Connection

Cannot open file logo.png.
File does not exist.

Page Contents: Interface - BLDC Connection.SchDoc

Drawn By: NagyRichard | Checked By: NagyRichard
Size: A4 | 21 Number: | Revision:
Date: 17/03/2025 | Time: 16:35:57 | Sheet 19 of

License:
Email: #NAME?
C:\Users\richa\Documents\EmbedCore\Mobile BLDC Motor Driver\BLDC Motor Driver\Schematic\Interface - BLDC Connection.SchDoc

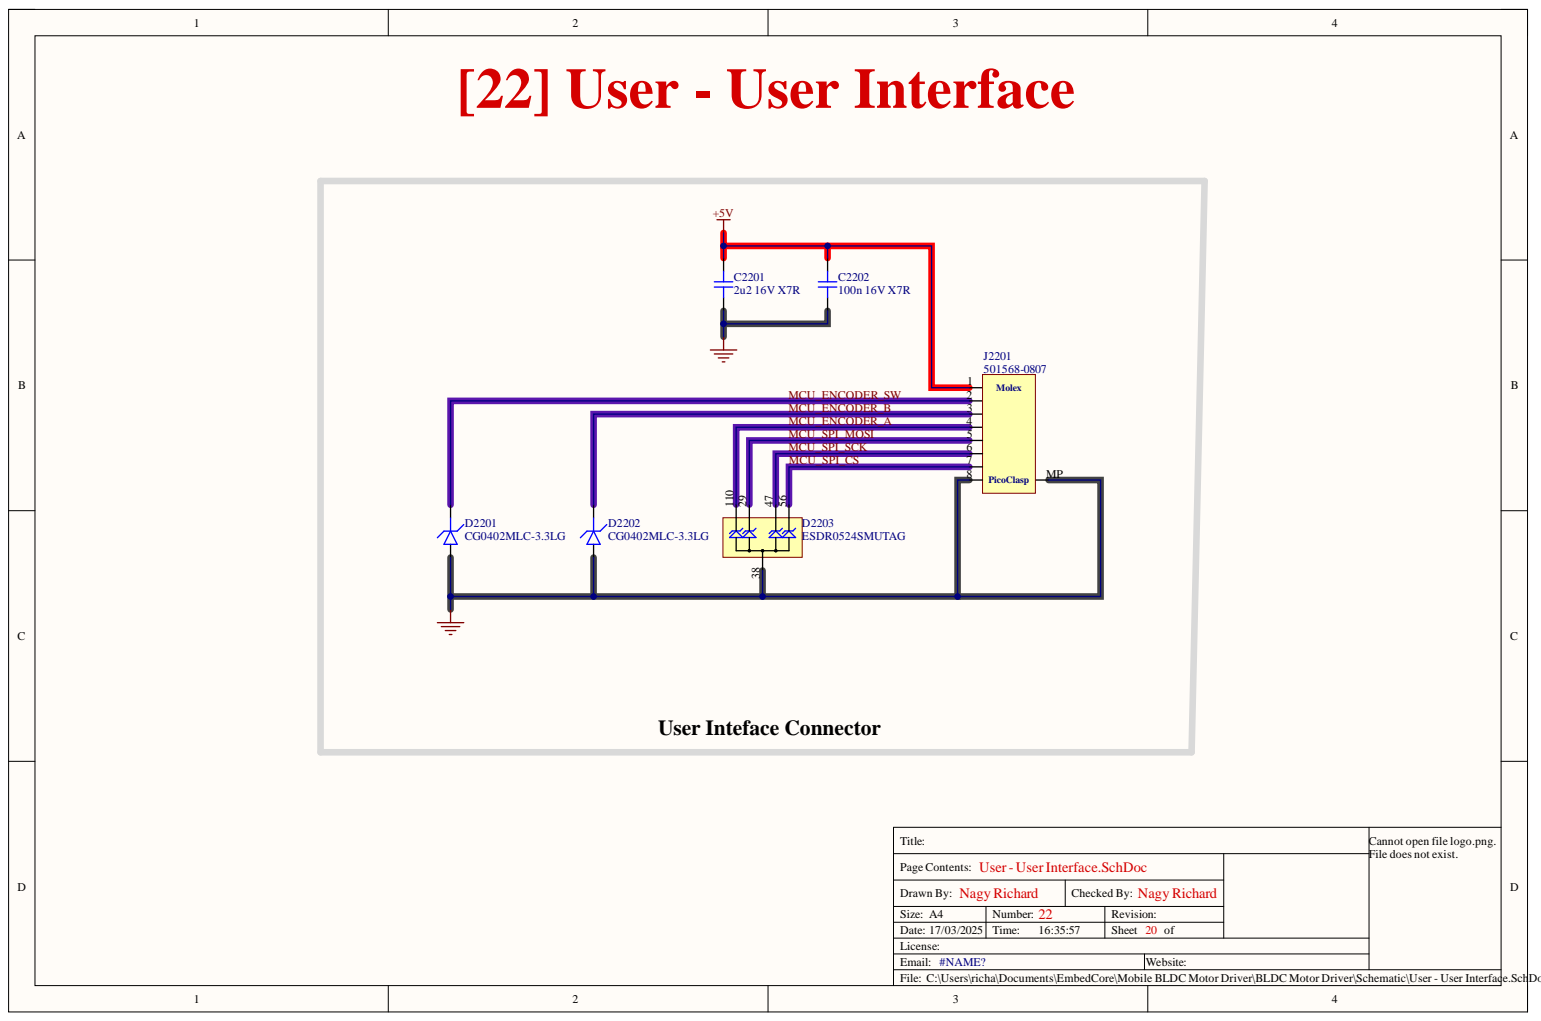
[picture p20: page 20]

MCU _ E NCO D E R_B
MCU _ E NCO D E R_A
MCU _SPI_MO S I

MCU _SPI_SC K | 5678

MCU _SPI_ C S

Page Co n ten t s : User - User Interfa c e.S c hDo

Draw n By : Na g yRic h ard | Checked By : Na g yRic h ard
Size : A 4 | 2 2 N umb er : | Rev i s i o n :
Dat e : 1 7 / 0 3 / 2 0 2 5 | T ime : 1 6 : 3 5 : 5 7 | Shee t 2 0 o f

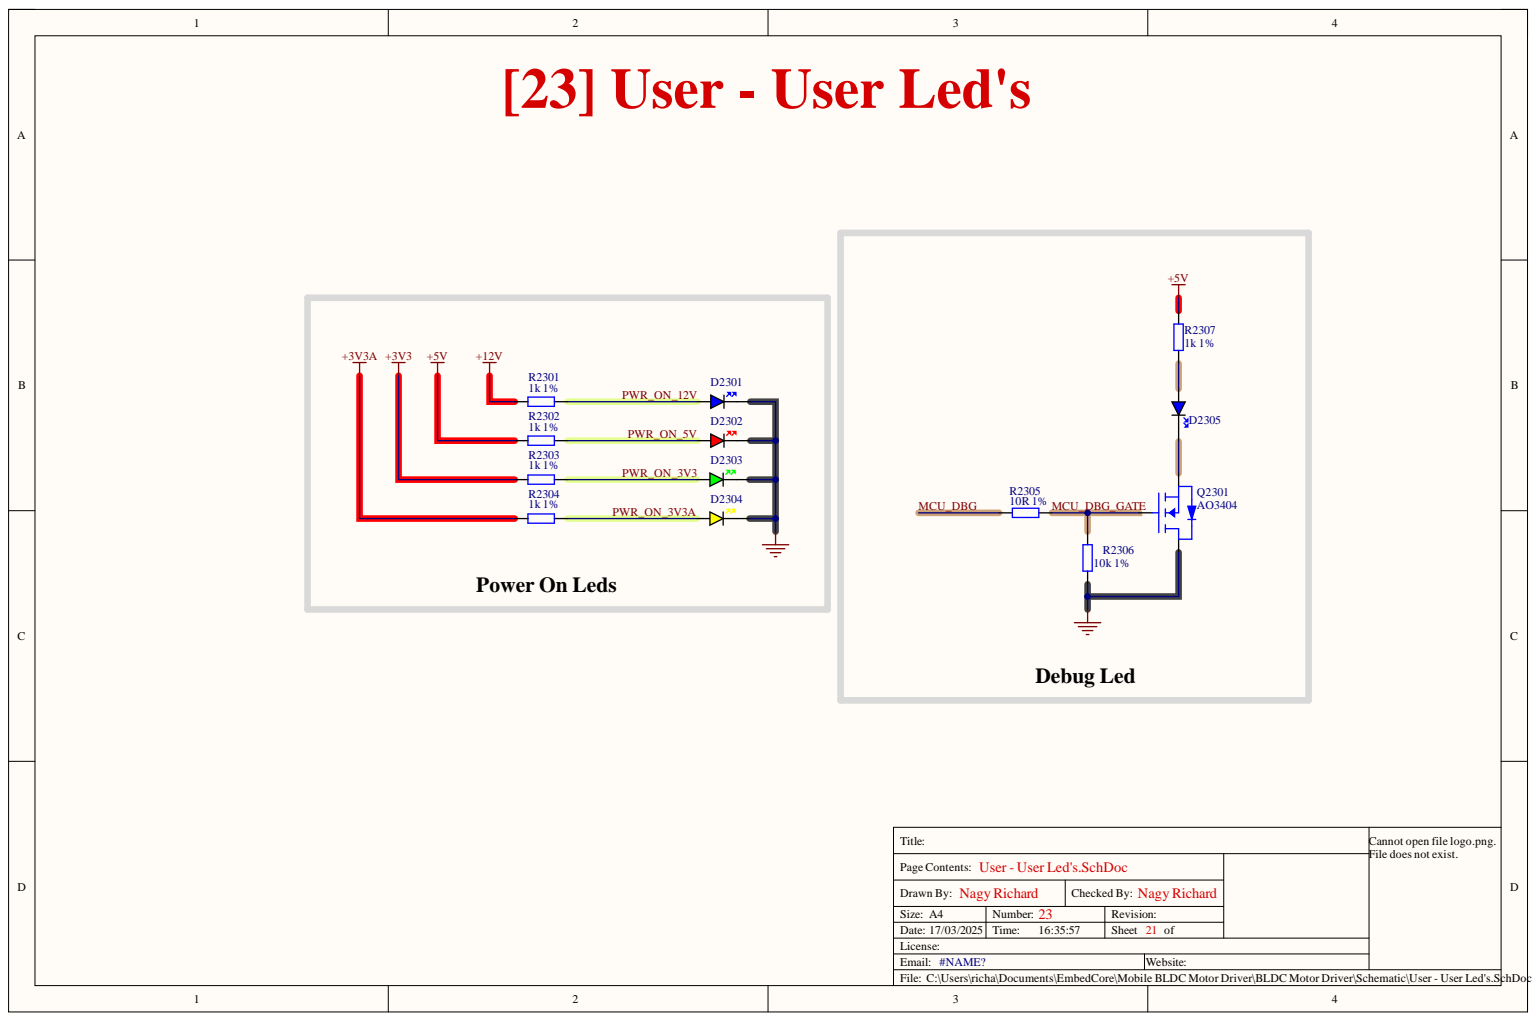
[picture p21: page 21]

Page Co n ten t s : User - User Le d's.S c hDo c

Draw n By : Na g yRic h ard | Checked By : Na g yRic h ard
Size : A 4 | 2 3 N umb er : | Rev i s i o n :
Dat e : 1 7 / 0 3 / 2 0 2 5 | T ime : 1 6 : 3 5 : 5 7 | Shee t 2 1 o f

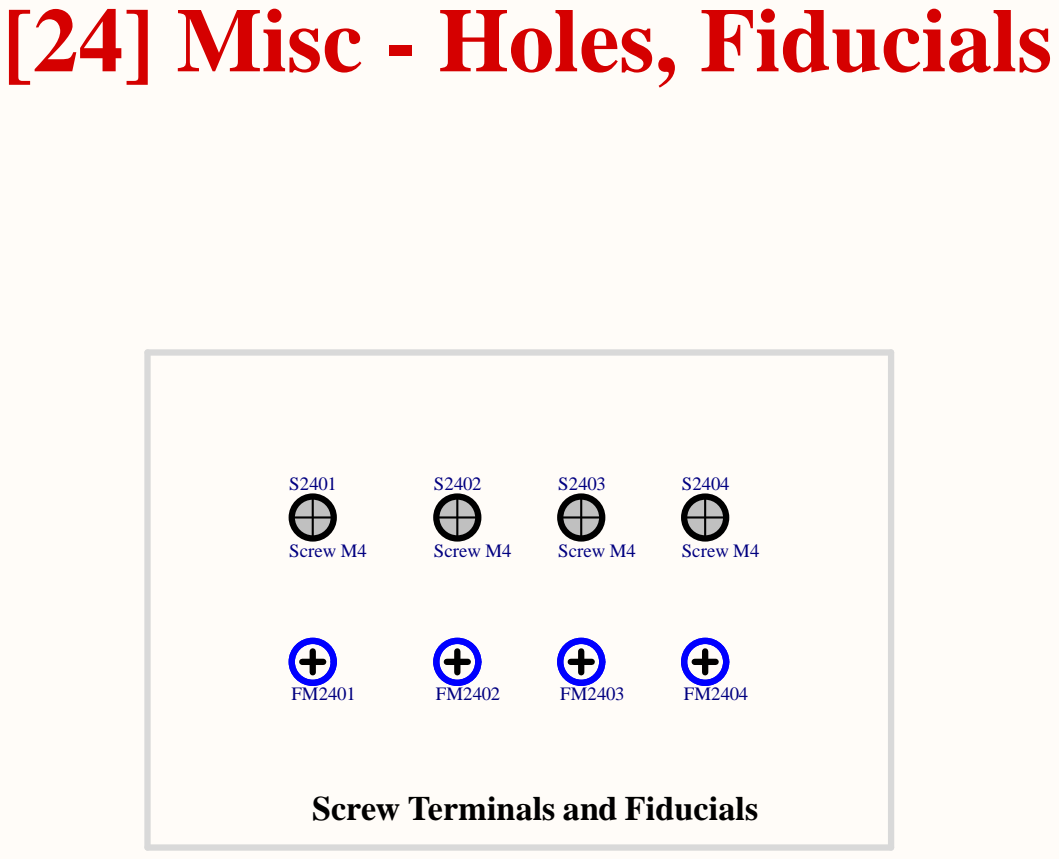
[picture p22: page 22]

Screw Terminals and Fiducials

Cannot open file logo.png.
File does not exist.

Page Contents: Misc - Holes, Fiducials.SchDoc

Drawn By: NagyRichard | Checked By: NagyRichard
Size: A4 | 24 Number: | Revision:
Date: 17/03/2025 | Time: 16:35:58 | Sheet 22 of

License:
Email: #NAME?
C:\Users\richa\Documents\EmbedCore\Mobile BLDC Motor Driver\BLDC Motor Driver\Schematic\Misc - Holes, Fiducials.SchDoc

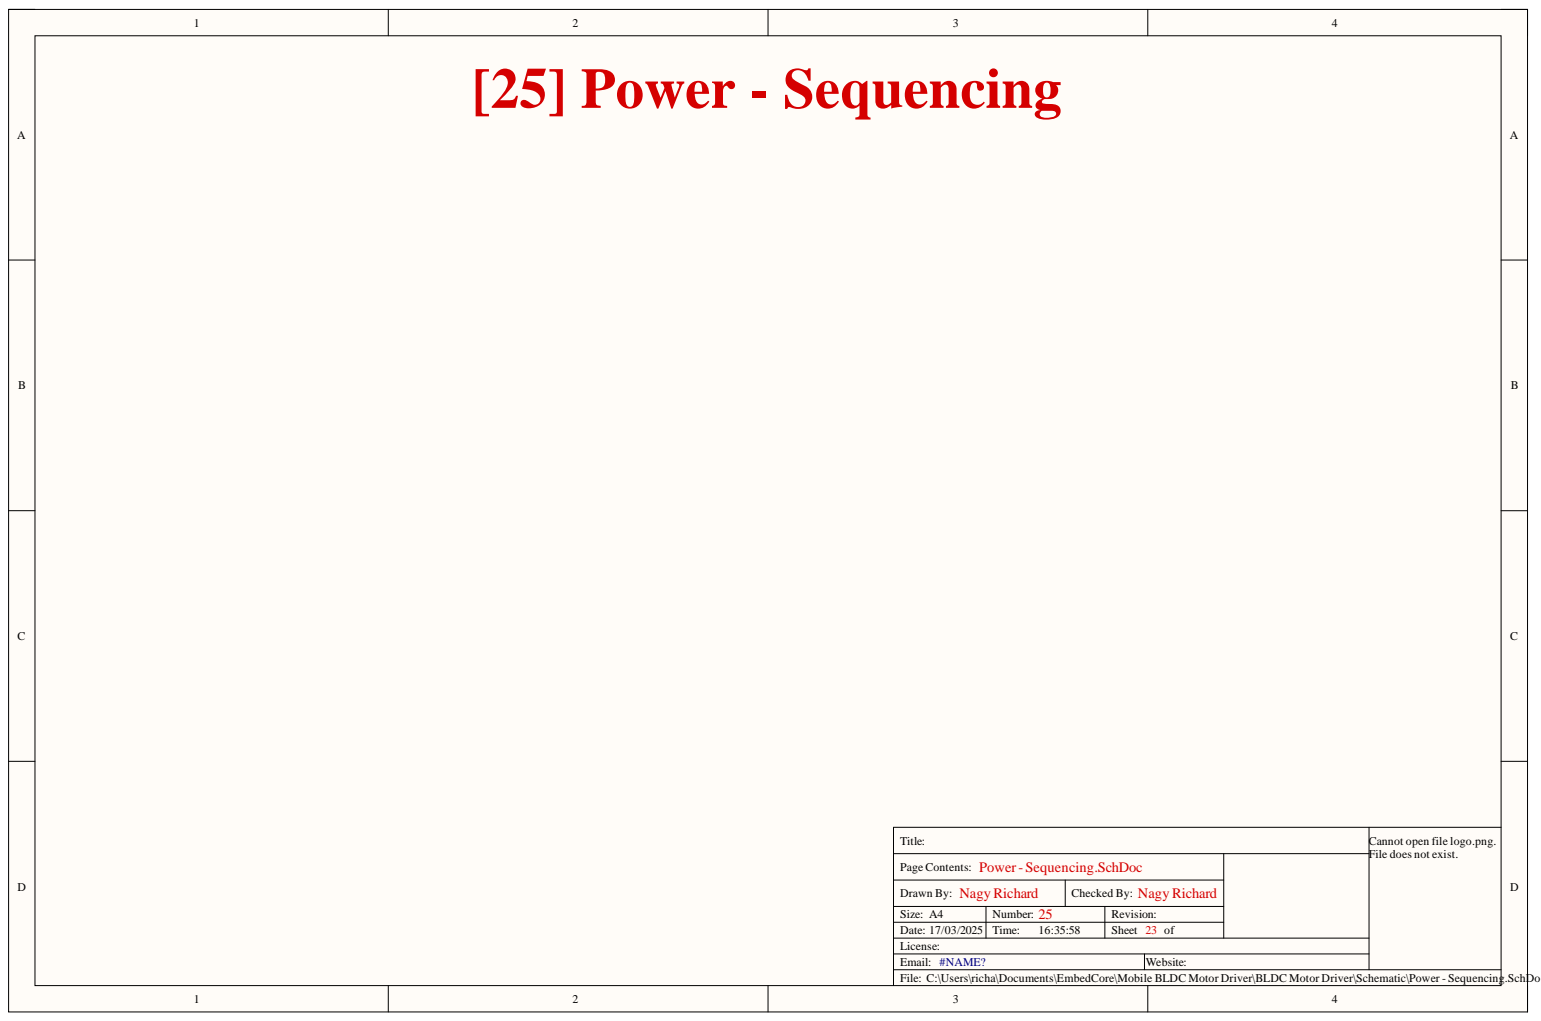
[picture p23: page 23]

Cannot open file logo.png.
File does not exist.

Page Contents: Power - Sequencing.SchDoc

Drawn By: NagyRichard | Checked By: NagyRichard
Size: A4 | 25 Number: | Revision:
Date: 17/03/2025 | Time: 16:35:58 | Sheet 23 of

License:
Email: #NAME?
C:\Users\richa\Documents\EmbedCore\Mobile BLDC Motor Driver\BLDC Motor Driver\Schematic\Power - Sequencing.SchDoc

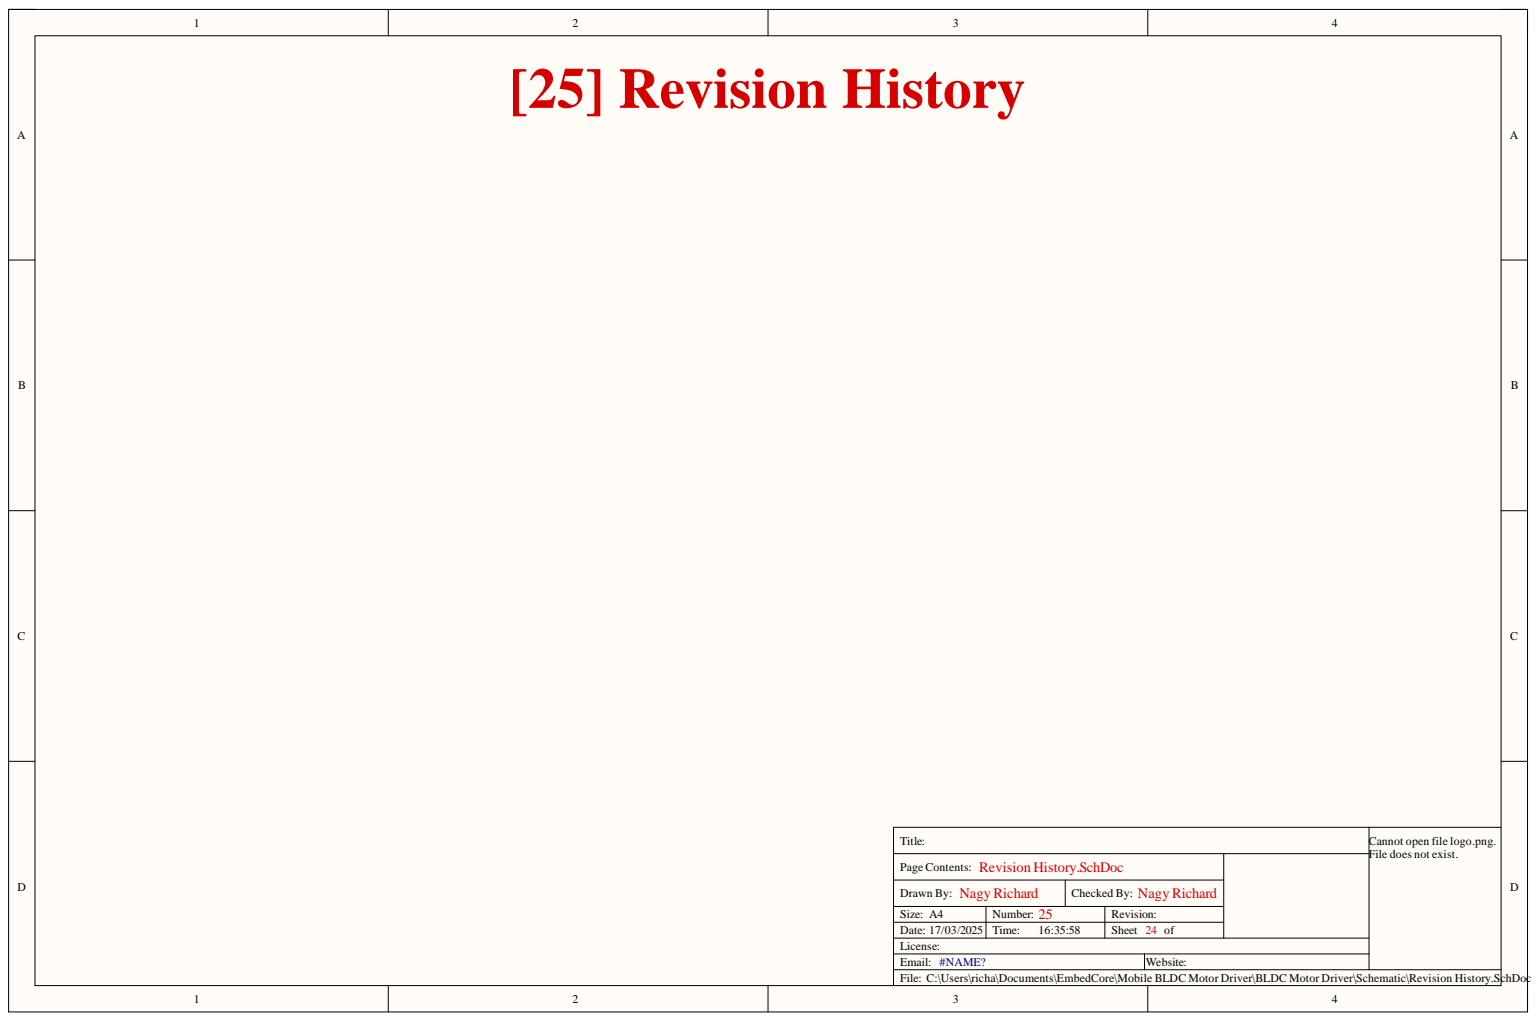
[picture p24: page 24]

Cannot open file logo.png.
File does not exist.

Page Contents: Revision History.SchDoc

Drawn By: NagyRichard | Checked By: NagyRichard
Size: A4 | 25 Number: | Revision:
Date: 17/03/2025 | Time: 16:35:58 | Sheet 24 of

License:
Email: #NAME?
C:\Users\richa\Documents\EmbedCore\Mobile BLDC Motor Driver\BLDC Motor Driver\Schematic\Revision History.SchDoc
