Ricsi1231/BLDC-Motor-Driver/BLDC Motor Driver/Documentation/PCB/PCB_Documentation_PDF.pdf

# BLDC Motor Driver - Realistic View

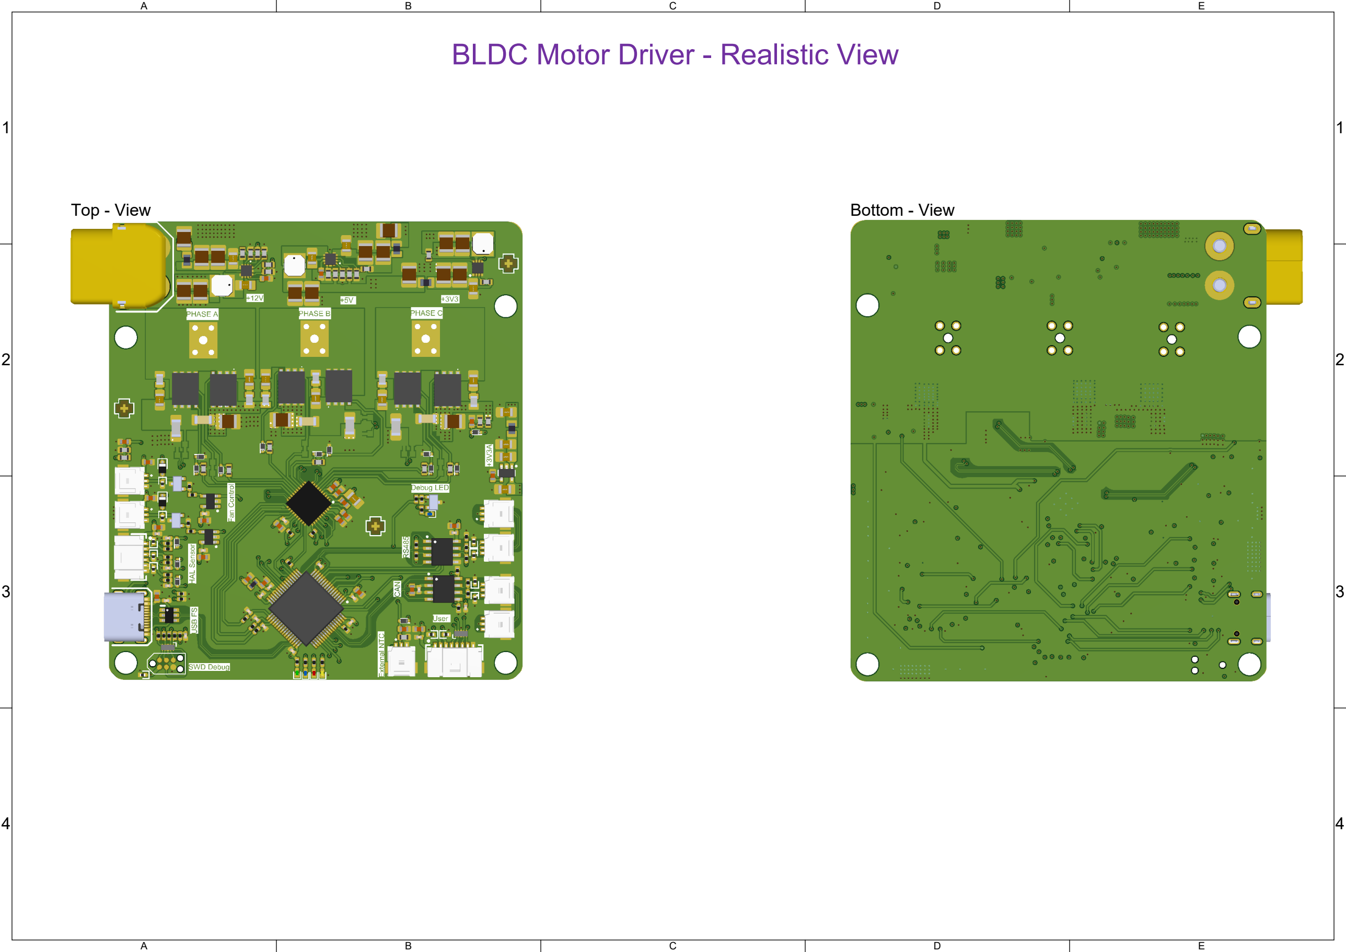
[picture p25: page 1]

A

B

C

D

E

1 | 1
2 | 2
3 | 3
4 | 4
Top - View | Bottom - View

# BLDC Motor Driver - ISO View

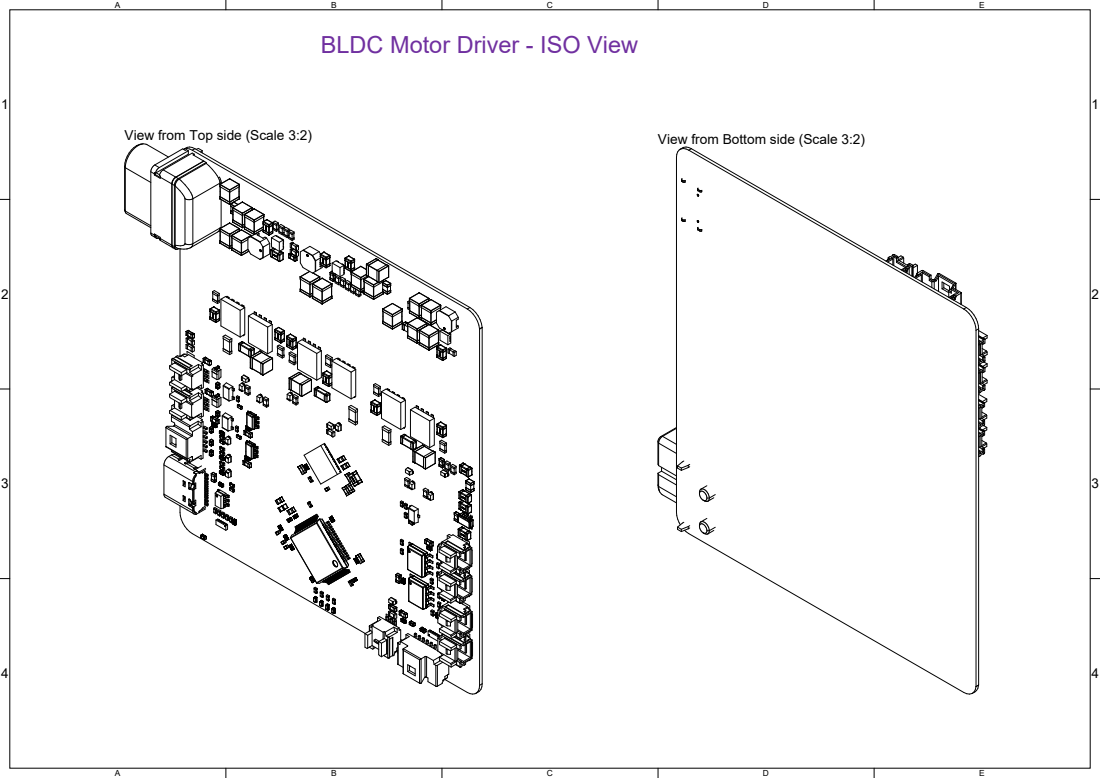
[picture p26: page 2]
View from Top side (Scale 3:2); View from Bottom side (Scale 3:2)

# BLDC Motor Driver - Layer Stackup

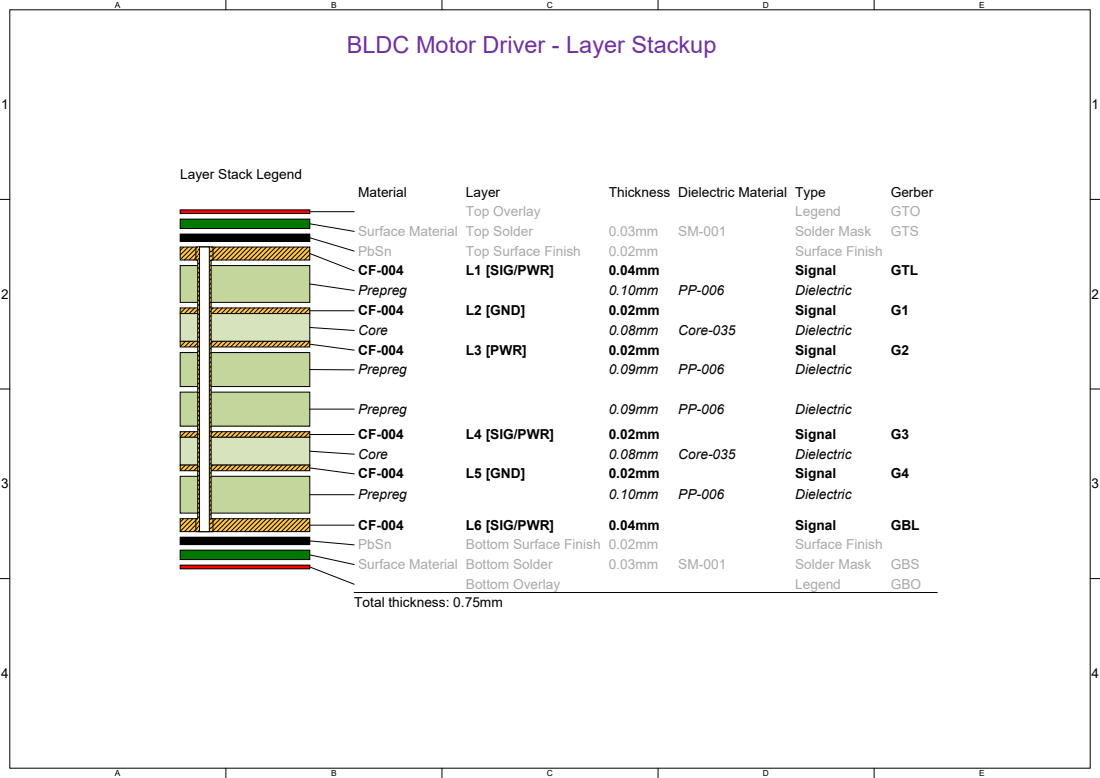
[picture p27: page 3]
Material; Layer; Thickness Dielectric Material Type; Gerber; Top Overlay; Legend; GTO; Surface Material Top Solder; Solder Mask; GTS; PbSn; Top Surface Finish; Surface Finish; L1 [SIG/PWR]; Signal; GTL; Prepreg; Dielectric; L2 [GND]; Core; Core-035; L3 [PWR]; L4 [SIG/PWR]; L5 [GND]; L6 [SIG/PWR]; GBL; Bottom Surface Finish 0.02mm; Surface Material Bottom Solder; GBS; Bottom Overlay; GBO; Total thickness: 0.75mm

Layer Stack Legend

# BLDC Motor Driver - Layers

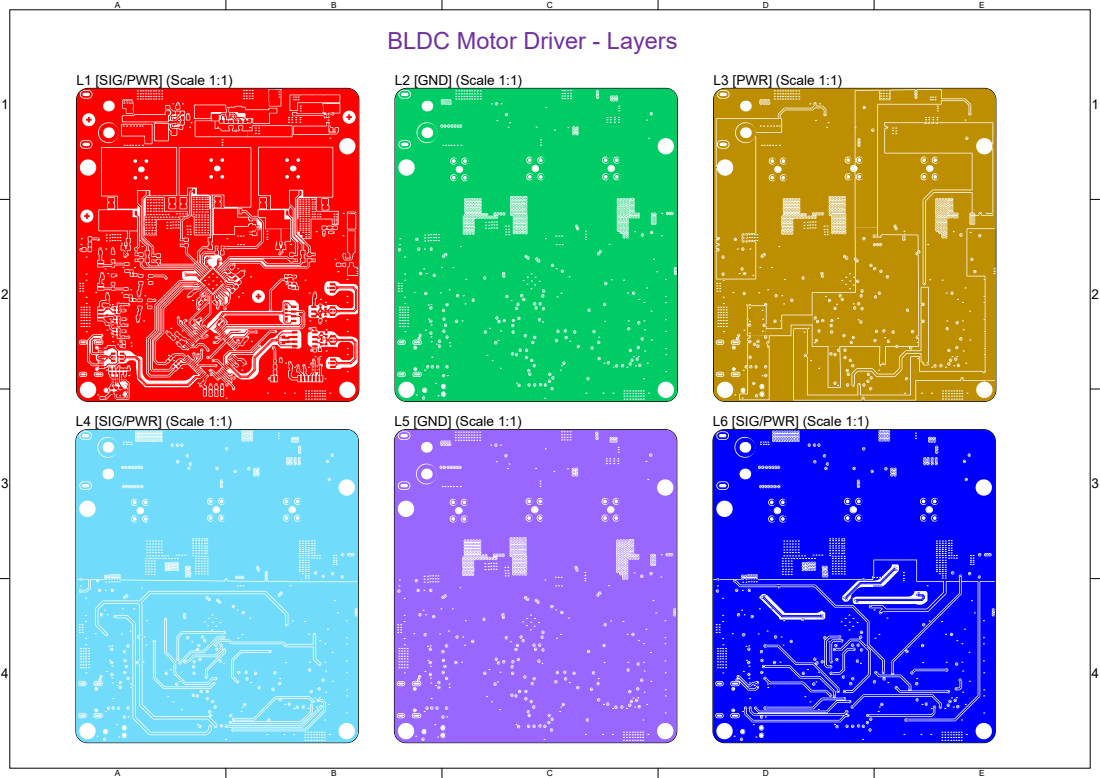
[picture p28: page 4]
L1 [SIG/PWR] (Scale 1:1); L2 [GND] (Scale 1:1); L3 [PWR] (Scale 1:1); L4 [SIG/PWR] (Scale 1:1); L5 [GND] (Scale 1:1); L6 [SIG/PWR] (Scale 1:1)

# BLDC Motor Driver - Drill Map

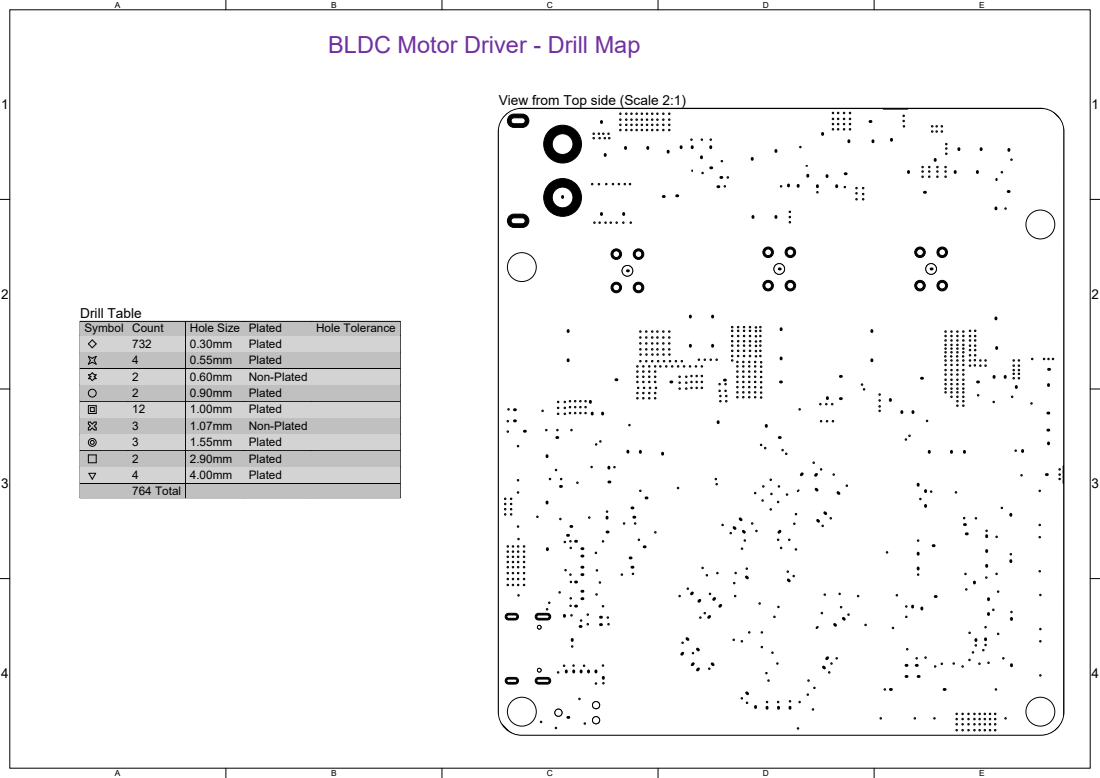
[picture p29: page 5]
Symbol Count 732 4 2 2 12 3 3 2 4 764 Total; Hole Size 0.30mm 0.55mm 0.60mm 0.90mm 1.00mm 1.07mm 1.55mm 2.90mm 4.00mm; Plated Plated Plated Non-Plated Plated Plated Non-Plated Plated Plated Plated; Hole Tolerance; Drill Table

View from Top side (Scale 2:1)

# BLDC Motor Driver - Assembly Top

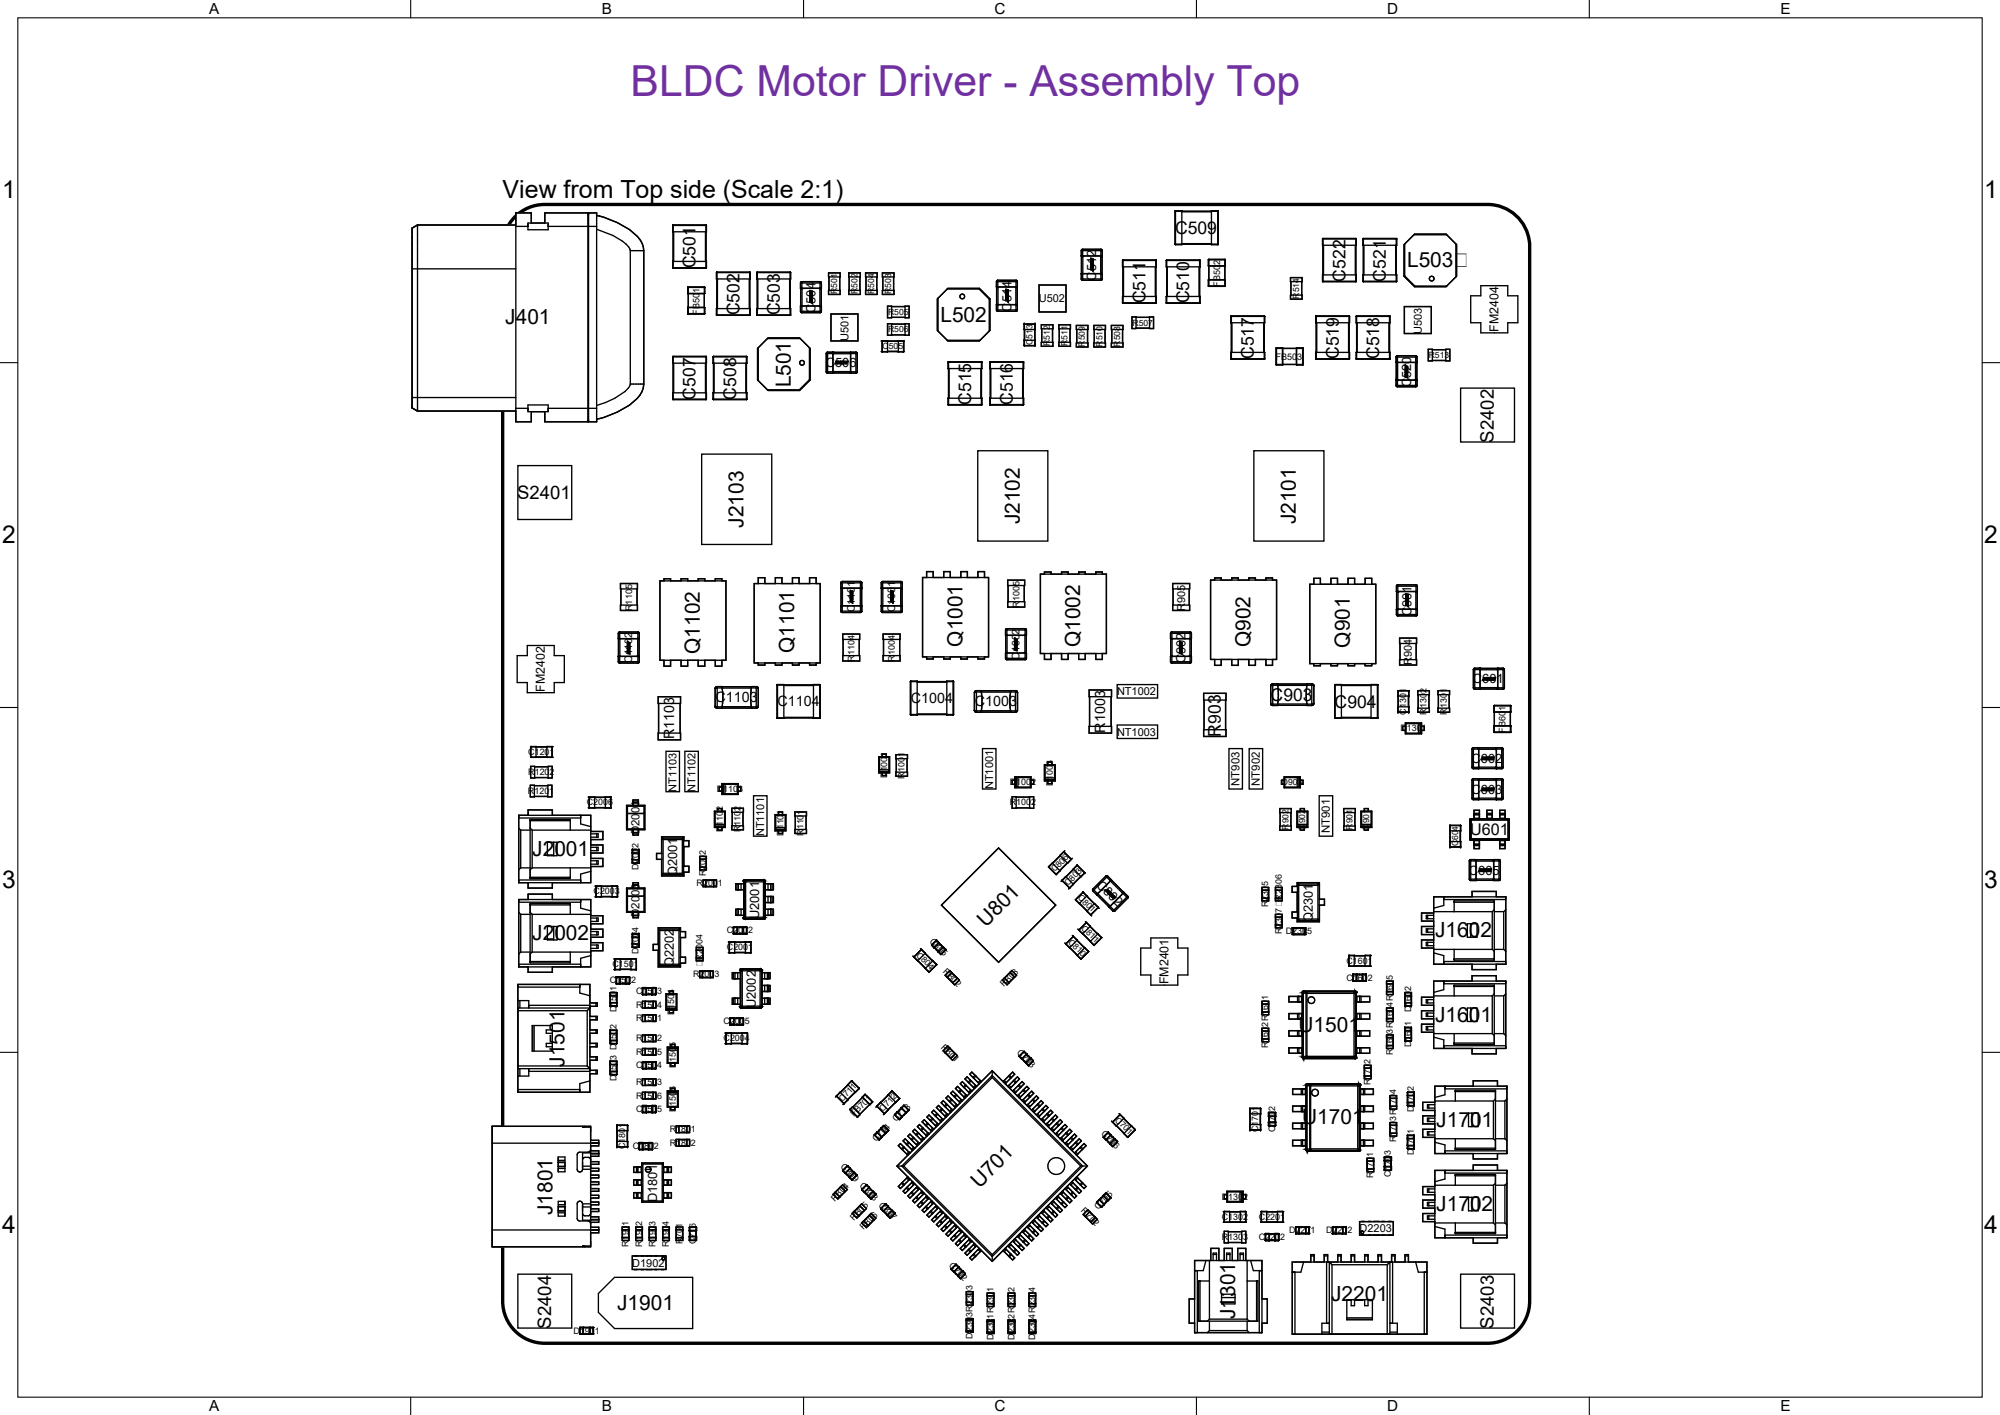
[picture p30: page 6]

View from Top side (Scale 2:1)

# BLDC Motor Driver - Assmebly Bottom

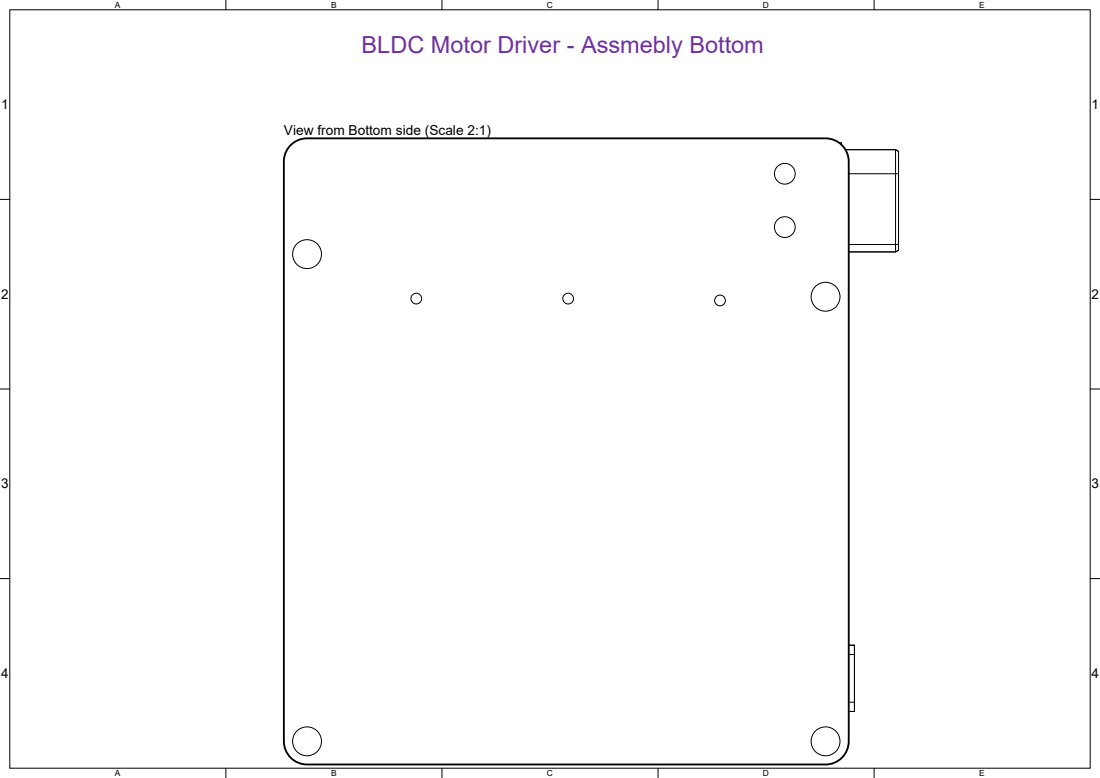
[picture p31: page 7]

View from Bottom side (Scale 2:1)
