Ricsi1231/BLDC-Motor-Driver/(list of files, drawings)

Other design files:
BLDC Motor Driver/BLDC Motor Driver.PrjPcb
BLDC Motor Driver/Schematic/Block Diagram.SchDoc
BLDC Motor Driver/Schematic/Cover Page.SchDoc
BLDC Motor Driver/Schematic/Interface - BLDC Connection.SchDoc
BLDC Motor Driver/Schematic/Interface - CAN.SchDoc
BLDC Motor Driver/Schematic/Interface - Fan Control.SchDoc
BLDC Motor Driver/Schematic/Interface - RS485.SchDoc
BLDC Motor Driver/Schematic/Interface - SWD.SchDoc
BLDC Motor Driver/Schematic/Interface - USB-C.SchDoc
BLDC Motor Driver/Schematic/MCU - Power and I_O.SchDoc
BLDC Motor Driver/Schematic/Misc - Holes, Fiducials.SchDoc
BLDC Motor Driver/Schematic/Motor Control - Phase A.SchDoc
BLDC Motor Driver/Schematic/Motor Control - Phase B.SchDoc
BLDC Motor Driver/Schematic/Motor Control - Phase C.SchDoc
BLDC Motor Driver/Schematic/Motor Control - Top Level.SchDoc
BLDC Motor Driver/Schematic/Power - Sequencing.SchDoc
BLDC Motor Driver/Schematic/Power Generation - Buck Converter.SchDoc
BLDC Motor Driver/Schematic/Power Generation - Connector.SchDoc
BLDC Motor Driver/Schematic/Power Generation - LDO.SchDoc
BLDC Motor Driver/Schematic/Revision History.SchDoc
BLDC Motor Driver/Schematic/Sensing - HAL Sensor.SchDoc
BLDC Motor Driver/Schematic/Sensing - Temperature.SchDoc
BLDC Motor Driver/Schematic/Sensing - Voltage.SchDoc
BLDC Motor Driver/Schematic/User - User Interface.SchDoc
BLDC Motor Driver/Schematic/User - User Led's.SchDoc
